xdxfgc/chuan-bo-tong-xin/beidou_gps_test/README.md

# 船舶终端（ESP32 + 北斗 + 激光测距 + LoRa 信标接收 + 语音播报）

一块板子做四件事：读北斗定位、读激光测距、用 LoRa 收信标坐标、用语音把落水信标的方向和距离喊出来，
同时把这些数据发布到网页上。

## 一、代码结构

程序按功能拆成模块，每个模块一对 `.h` / `.cpp`，配置集中在 `config.h`。
以后新增硬件，照 `tof.h` / `tof.cpp` 的写法再加一对文件，
然后在主程序 `setup()` 里加一行 `xxxBegin()`、在 `loop()` 里加一行 `xxxUpdate()` 即可。

| 文件 | 作用 |
| --- | --- |
| `beidou_gps_test.ino` | 主程序：初始化各模块并调度 |
| `config.h` | 全部引脚、WiFi、射频、播报节奏等参数 |
| `gb2312_voice.h` | SYN6288 播报用的 GB2312 词表 |
| `gnss.h` / `gnss.cpp` | 北斗定位：NMEA 解析、0x01 位姿帧、定位失锁告警 |
| `tof.h` / `tof.cpp` | 激光测距 VL53L1X ×2：船头（前方距离）+ 右舷（侧靠距离） |
| `oled.h` / `oled.cpp` | OLED 显示（SSD1306 128x64，与激光共用 I2C） |
| `imu.h` / `imu.cpp` | MPU6050 六轴姿态（同样挂在 I2C 总线上） |
| `mag.h` / `mag.cpp` | 磁力计 GY-282（HMC5983）：航向、标定、I2C 自恢复，走**独立的 Wire1** |
| `berth.h` / `berth.cpp` | 靠泊辅助：距离滤波、接近速度拟合、分级告警、靠妥判定 |
| `buzzer.h` / `buzzer.cpp` | 蜂鸣器：汇总各级告警，用不同节奏响铃，支持网页开关 |
| `anchor.h` / `anchor.cpp` | 走锚监测：基准位置、位移平滑、漂移趋势、0x21/0x22 告警 |
| `logbook.h` / `logbook.cpp` | 数据记录与回放：每秒存一帧，可下载 CSV、按时间轴回放 |
| `button.h` / `button.cpp` | 板载 BOOT 键：短按设出发点，长按开始标定 |
| `cmd.h` / `cmd.cpp` | 串口命令：音量、标定、出发点、磁偏角、扫描 |
| `lora_link.h` / `lora_link.cpp` | LoRa 收发与 ACK 应答 |
| `voice.h` / `voice.cpp` | SYN6288 语音播报与在线调音量 |
| `beacon.h` / `beacon.cpp` | 信标接收、方位解算、搜索引导、播报节流 |
| `net.h` / `net.cpp` | WiFi 与网页服务（页面 + JSON 接口） |

依赖方向是单向的：`config` 在最底层；`beacon` 用到 `gnss`/`lora`/`voice`；
`net` 用到 `gnss`/`tof`/`beacon`；主程序把它们串起来。

注意：LoRa 模块的文件名是 `lora_link.*`，不能叫 `lora.*`。Windows 不区分文件名大小写，
如果叫 `lora.h`，`#include <LoRa.h>`（库头文件）会优先匹配到同目录的这个文件，
导致库加载失败、编译时报 `'LoRa' was not declared`。

## 二、接线

北斗定位模块 ATGM336H-5N：

| 模块引脚 | ESP32 | 说明 |
| --- | --- | --- |
| 5V | 5V | 供电 |
| GND | GND | 必须共地 |
| TX | GPIO17 | 模块发数据，接 ESP32 接收脚 |
| RX | GPIO18 | ESP32 发数据，接模块接收脚 |

激光测距模块 VL53L1X ×2（I2C，船头一只 + 右舷一只）：

| 模块引脚 | ESP32 | 说明 |
| --- | --- | --- |
| VIN | 3.3V | 只能接 3.3V，接 5V 会烧坏 |
| GND | GND | 必须共地 |
| SCL | GPIO22 | I2C 时钟 |
| SDA | GPIO21 | I2C 数据 |
| GPIO1 | 空着 | 可以不接 |

两只都是 I2C，**SDA/SCL 并联到同一对 GPIO21/22**（I2C 是总线，靠地址区分设备，
不是一根线只能挂一个模块）。但两只 VL53L1X 出厂地址**都是 0x29**，直接并上去会
互相打架，所以右舷那只要多接一根 XSHUT：

| 第 2 只（右舷）引脚 | ESP32 | 说明 |
| --- | --- | --- |
| VIN / GND | 3.3V / GND | 和船头那只共用 |
| SDA / SCL | GPIO21 / GPIO22 | 和船头那只并联 |
| **XSHUT** | **GPIO32** | 上电时序用，**必须接**；船头那只的 XSHUT 保持空着 |

上电顺序写死在 `tofBegin()` 里：按住右舷那只 → 船头那只拿到 0x29 →
把它改到 0x2A → 放开右舷那只（它回到 0x29）。这样两只地址就分开了。
串口会打印两只各自的地址，看到两个不同的地址才算成功。

OLED 显示屏 SSD1306（I2C，和激光共用同一条总线）：

| 模块引脚 | ESP32 | 说明 |
| --- | --- | --- |
| VCC | 3.3V | 供电 |
| GND | GND | 共地 |
| SDA | GPIO21 | 和激光共用 |
| SCL | GPIO22 | 和激光共用 |
| 地址 | 0x3C | 少数模块是 0x3D，读不出就改 config.h |

MPU6050 六轴姿态（I2C，同样挂在这条总线上）：

| 模块引脚 | ESP32 | 说明 |
| --- | --- | --- |
| VCC | 3.3V | 供电 |
| GND | GND | 共地 |
| SDA | GPIO21 | 和激光、OLED 共用 |
| SCL | GPIO22 | 和激光、OLED 共用 |
| AD0 / ADO | GND 或不接 | 地址 0x68；接高电平变 0x69 |
| INT / XDA / XCL | 不接 | 暂时用不上 |

磁力计 GY-282 / HMC5983（**单独一路 I2C，不和其他模块共用**）：

| 模块引脚 | ESP32 | 说明 |
| --- | --- | --- |
| VCC | **3.3V** | 不能接 5V：上拉电阻会跟着抬到 5V，超出 ESP32 的 IO 耐压 |
| GND | GND | 共地 |
| SDA | **GPIO25** | 走 Wire1 |
| SCL | **GPIO26** | 走 Wire1 |

两条 I2C 总线是分开的：**Wire**（GPIO21/22）挂激光 0x29、OLED 0x3C、MPU6050 0x68；
**Wire1**（GPIO25/26）只挂磁力计 0x1E。分开的原因是磁力计代码里带自动降速和总线复位，
和激光共用一条线时，它一折腾会连带影响每 50 毫秒就要读一次的激光测距。
想省一对脚的话，把 `config.h` 里的 `I2C_BUS_INDEX` 改成 0、`I2C_SDA`/`I2C_SCL` 改成 21/22 即可。

I2C 是总线，多个器件共用同样两根线靠地址区分：**激光 0x29、OLED 0x3C、MPU6050 0x68**，
三个地址互不冲突，挂在一起没问题。

⚠ MPU6050 里没有磁力计：俯仰角和横滚角很准，但偏航角（船头朝向）会随时间漂移。
要做到"信标在左前方"这种相对船头的播报，还需要再加一片三轴磁力计（文档里配的是 QMC5883L，
地址 0x0D，同样可以挂在这条总线上）。

LoRa 模块 SX1278（Ra-01 / Ra-02，433MHz，SPI）：

| 模块引脚 | ESP32 | 说明 |
| --- | --- | --- |
| VCC | 3.3V | 只能 3.3V |
| GND | GND | 共地 |
| SCK | GPIO14 | SPI 时钟 |
| MISO | GPIO19 | SPI 数据入 |
| MOSI | GPIO23 | SPI 数据出 |
| NSS | GPIO13 | 片选 |
| RST | GPIO27 | 复位 |
| DIO0 | 不接 | 程序用轮询，不需要中断脚 |

SYN6288 语音模块：

| 模块引脚 | ESP32 | 说明 |
| --- | --- | --- |
| RXD | GPIO16 | 必接，ESP32 发、模块收 |
| TXD | GPIO4 | 可选，接上能看到模块应答 0x41 |
| VCC | 5V | 功放吃电流，5V 声音才够大 |
| GND | GND | 共地 |
| SPK+ / SPK- | 喇叭 | 接小喇叭 |

接 ESP32 时，北斗模块上的 USB 口不要同时插到电脑，两者是同一路串口，会冲突。
北斗天线要拧到 SMA 口上，放在露天、平面朝天，远离金属。

## 三、WiFi 配置

相关设置都在 `config.h` 里。当前用固定 IP，网页地址固定为 **http://192.168.31.200**。

| 项目 | 值 |
| --- | --- |
| SSID | Xiaomi_AE4D |
| 密码 | 123456780 |
| 网段 | 192.168.31.x |

小米路由器有两个 WiFi 名字：**不带 `_5G` 的是 2.4GHz，带 `_5G` 的是 5GHz**。
ESP32 只支持 2.4GHz，必须用 `Xiaomi_AE4D`。

固定 IP 连不上会自动回退成路由器自动分配；再连不上就开热点兜底：
热点名 `Beidou-GPS`、密码 `12345678`、网页地址 http://192.168.4.1。

## 四、LoRa 通信协议

和信标端（ESP32-C3）约定好的文本协议，两边必须一致：

```
信标 → 广播：  M,<信标ID>,<序号>,P,<定位有效 0/1>,<纬度>,<经度>
本板 → 广播：  S,<船ID>,<序号>,P,<定位有效 0/1>,<纬度>,<经度>,<对地速度节>,<航向度>,<卫星数>
本板 → 信标：  A,<船ID>,<序号>,C,<本方定位有效 0/1>,<纬度>,<经度>
```

**第二位是发送者标识**：船端用 `DEV_ID = 1`，信标用 11 / 12 / 13（在各自的 `config.h` 里设）。
岸基节点靠它区分"这一帧是谁发的"，才能同时管理多个目标。
收到带编号的帧时，串口、OLED 和网页上都会显示是哪个信标。

**前缀区分角色**：`M` 是信标、`S` 是本船广播、`A` 是应答。

信标每 2 秒发一次，本板收到立刻回 ACK，信标靠它判断这一轮成功。
本板自己也广播一帧自己的状态（`BROADCAST_MS`），这样岸基节点才有东西可收。
**但广播要让信标的路**：本机一发射就听不见东西（半双工），原来固定每 2 秒发一帧，
刚好和信标 2 秒一次的上报同拍，会把 SOS 包顶掉、逼信标重传。现在的规则是——

- 信标不在线（超过 `BROADCAST_QUIET_MS` 没收到包）：每 `BROADCAST_MS`（5 秒）发一帧
- 信标在线：只在**刚给信标回完 ACK、信标正处在自己那 2 秒静默期**的空档里发
  （收到包后 `BROADCAST_SLOT_MIN_MS` ~ `BROADCAST_SLOT_MAX_MS` 这段窗口），
  所以实际间隔约 5~8 秒，永远不会压住 SOS

判断用的是 `beaconLastPacketAgeMs()`：距上次收到信标包过了多久。收包时刻本身就是
最好的相位基准，不用两端对表。
重传识别是**按发送者分开记**的：同一只发送者、同一序号重复到达只回 ACK，
不重复播报；多只信标同时工作时不会互相误判成重传。

解析器**两种格式都认**：如果第二个字段是数字就是新格式（带 ID），第三个字段是 `P` 就是老格式（没有 ID，当作 srcId = 0）。这样以后碰到别的项目里现成的发送端，不改它也能收。

射频参数两端必须完全相同：`433MHz / SF10 / BW125kHz / 同步字 0x12 / 开启 CRC`。

## 五、语音播报

SYN6288 只认 GB2312，不能直接发 UTF-8 中文，所以 `gb2312_voice.h` 里把要用到的词
预先算成字节，数字和 `[v16]` 音量标记在运行时拼上去。

播报内容形如："人员落水，信标在东北方向，距离约 123 米，坐标北纬 26.2091 度，东经 111.5989 度。"

为避免语音排队，做了节流：两次播报最短间隔 8 秒；目标移动超过 3 米、方位变化、
或超过 20 秒，才重新播报。链路中断超过 15 秒播报"与信标失去联系"，恢复时播报"通信已恢复"。

方位播报会优先使用**相对船头**的八个方位（正前方、右前方……左前方），前提是磁力计在位**并且已经标定**；
没标定或者磁力计掉线时，自动退回"信标在东北方向"这样的绝对方位，避免给出错误指引。

## 六、串口命令

串口监视器波特率 **115200**，行尾选「换行」或「NL & CR」。输入 `help` 可以看全部命令：

| 命令 | 作用 |
| --- | --- |
| `v0` ~ `v16` | 语音音量（会播一句"你好"试听） |
| `cal [秒]` | 开始磁力计标定，默认 15 秒（拿起来绕「8」字慢慢转） |
| `cal stop` | 提前结束标定 |
| `cal reset` | 清除已保存的标定 |
| `zero` | 把当前船头朝向设为出发点（0°） |
| `decl -5.2` | 设置磁偏角（真北修正），长沙一带约 -5 |
| `mag` | 立刻打印一行磁力计数据 |
| `dock` | 打印靠泊状态（距离、接近速度、告警） |
| `scan` | 扫描磁力计所在的 I2C 总线，正常应看到 0x1E |
| `ack` | 确认落水告警（停止蜂鸣器） |
| `buzz on` / `buzz off` | 打开或关闭蜂鸣器（网页上也有按钮） |
| `moor set` | 把当前位置设为锚泊基准，开始走锚监测 |
| `moor clear` | 清除锚泊基准，停止监测 |
| `moor` | 打印锚泊状态（位移、漂移方向与速率） |
| `log on` / `log off` | 开始或暂停数据记录 |
| `log dump` | 把已记录的数据以 CSV 打印到串口（可直接存成文件） |
| `log clear` | 清空记录 |

## 七、板载按键

ESP32 开发板上的 **BOOT 键**（GPIO0）可以直接操作，不用开电脑：

| 动作 | 效果 |
| --- | --- |
| 短按 | 把当前船头朝向设为出发点（0°） |
| 长按 3 秒 | 开始磁力计标定 |
| 标定中短按 | 提前结束标定，用已转到数据算结果 |

不想用就把 `config.h` 里的 `BTN_ENABLE` 改成 0。

## 八、靠泊辅助

只用激光测距，不需要额外硬件。**靠近到 3.5 米自动开始监测**，离开到 3.8 米（滞回 0.3 米）
并持续 3 秒后自动结束。

### 用哪一路激光：右舷优先，看不到岸就退回船头

船上装了两只激光：

- **船头那只**测正前方到岸/障碍的距离 —— 顶着靠、前方防撞
- **右舷那只**测船侧到码头的横向距离 —— **侧靠**，也就是真实船舶靠泊的方式

两只都有效时怎么选，`config.h` 里的 `BERTH_SRC_MODE` 决定：

| 值 | 含义 |
| --- | --- |
| `BERTH_SRC_AUTO`（默认 `0`） | 右舷那只有效、且距离进了靠泊区 → 用右舷；否则自动退回船头 |
| `BERTH_SRC_BOW`（`1`） | 固定用船头（顶着靠） |
| `BERTH_SRC_SIDE`（`2`） | 固定用右舷（侧靠） |

**为什么要"自动"**：这样你两种演示都不用改代码、也不用重新烧录——船头对着岸开过去时，
右舷那只照到的是一片水面、读数是无效的，逻辑自动用船头；船横过来贴近码头时，
右舷那只一进到 3.5 米就被选中。判定动画和告警规则**完全一样**，只是数据来源换了。

退回船头的时候用**退出阈值 3.8 米**做滞回，免得两个距离在 3.5 米附近来回跳——
每跳一次都会重开一次监测，那样永远判不出靠妥。

中途换源（比如从顶着靠改成侧靠）时会**主动结束本次监测、当新事件重新进入**。
因为两路距离的基准不一样，硬接着算会在速度拟合窗里顶出一个假尖峰，直接变成误告警。

网页「④ 靠泊」里有一栏"**数据来源**"，直接告诉你当前用的是船头还是右舷；
OLED 靠泊画面的标题也会变成"靠泊·右舷"或"靠泊·船头"。

处理链是：原始距离先做 3 点中值去野值，再做 8 点滑动平均；然后用 0.4 秒窗口做最小二乘拟合
求接近速度。这两步是必须的——激光噪声约 ±5 毫米，直接拿相邻两帧求差算速度，误差有 0.1 m/s，
而提醒阈值才 0.15 m/s，噪声就能把告警刷满。

判断规则按文档附录 B：

| 告警码 | 条件 | 等级 | 播报 |
| --- | --- | --- | --- |
| 0x01 | 接近速度 > 0.15 m/s | 提醒级 | 靠泊速度偏大，请减速 |
| 0x02 | 接近速度 > 0.30 m/s | 严重级 | 靠泊速度过大，立即停船 |
| 0x03 | 距岸 < 0.5 米且速度 > 0.10 m/s | 严重级 | 距岸过近，请停船 |

告警带 3 帧去抖，并且**解除阈值比触发阈值松约 10%**：

| 告警码 | 触发 | 解除 |
| --- | --- | --- |
| 0x01 接近速度偏大 | 速度 > 0.15 | 速度 < 0.13 |
| 0x02 接近速度过大 | 速度 > 0.30 | 速度 < 0.27 |
| 0x03 距岸过近 | 距离 < 0.5 且速度 > 0.10 | 距离 > 0.55 或速度 < 0.09 |

光有去抖不够——速度正好在阈值上下浮动时，蜂鸣器会一秒响一次停一次地“哒哒”跳。
留出滞回差值之后就不会了。当前生效的那一级用解除阈值判断，其它级用触发阈值，
所以不会耽误升级（比如提醒级时速度冲到 0.31，立刻升到严重级）。

**距离播报**按档位给，越近播得越勤：

| 距离 | 播报 | 间隔 |
| --- | --- | --- |
| 3.5 ~ 2.0 米 | 距离三米二 | 2.5 秒 |
| 2.0 ~ 1.0 米 | 距离一米八 | 2.0 秒 |
| 1.0 ~ 0.5 米 | 距离八十厘米 | 2.0 秒 |
| 0.5 米以内 | 距离三十厘米，即将靠妥 | 2.0 秒 |

告警优先级高于距离播报，触发时先念告警。**拟合速度小于 0.02 m/s 时自动静默**，不会反复念
同一个数字。这里用速度而不是距离变化量来判断——船靠在码头边随浪起伏时距离一直在变，
用极差永远判不出"停稳"，而浪造成的往复平均速度接近零，用速度就能安静下来。

**靠妥判定**看的是"停下来"而不是"有多近"：速度小于 0.03 m/s（主判据）、观察窗内极差小于
8 厘米（辅助，用来挡住一个大浪把船推一截）、且距离小于 1 米，三条同时满足就播报"靠泊完成"。
这样护舷厚薄都不影响判定。另外，激光量程下限是 4 厘米，如果刚才还贴着、读数突然失效，
也判为已接触。

极差容差取 8 厘米而不是更小，是因为水面上的船一直在晃：3.2 秒内变化 3 厘米相当于 0.01 m/s，
比速度阈值还严三倍，正常靠泊永远达不到。

判定外面还套了四道防护，防止"一开机就对着近处目标"被误判成刚刚靠好：

- **窗口必须攒够样本**：拟合窗要填满（8 个点）、观察窗至少攒到一半（约 1.6 秒）。
  样本不足时不允许下结论——早期版本这里返回 0，被当成"速度为零、距离没变"，只要距离小于 1 米
  就会立刻误判靠妥。
- **进入监测后至少观察 2 秒**，刚进来什么都没看清不能判。
- **必须实际接近过 30 厘米以上**：记录进入监测后见过的最大距离，要求它和当前距离的差达标。
  这条专门挡住"开机时激光就已经对着 1 米以内目标"的情况。
- **离开岸壁会自动解除**：靠妥后如果距离超过 1.5 米并持续 1 秒，解除"已靠妥"回到监测状态，
  不会卡在靠妥状态出不来。

**屏幕占用**也有条件：只有出现告警、已经靠妥、或者船确实在移动（速度超过 0.01 m/s）时，
屏幕才切到靠泊画面；否则保持显示信标或本船画面，避免长时间停在近处就把别的画面顶掉。

阈值全在 `config.h` 里，实测觉得太敏感或太迟钝直接改。

## 九、蜂鸣器

有源蜂鸣器，接在 **GPIO33**（模块说明书里示例写的 GPIO27 已被 LoRa 的 RST 占用）。

| 模块引脚 | ESP32 |
| --- | --- |
| VCC | 3.3V |
| GND | GND |
| I/O | GPIO33 |

**触发极性**在 `config.h` 里选，两种模块都支持：

```
#define BUZZER_ACTIVE_LOW 0    // 1 = MH-FMD（低电平触发）  0 = MH-FMG（高电平触发）
```

接反了的表现正好相反：该响的时候不响、不该响的时候一直响。**上电时如果听到"滴"一声，多半就是极性设反了**——代码里已经把输出电平设在切换成输出之前，正常情况下上电不会响。

蜂鸣器把三个模块的告警汇总成一个等级，用不同节奏区分：

| 等级 | 触发条件 | 响法 |
| --- | --- | --- |
| 3 | 人员落水（收到信标有效坐标） | 三短声急促循环 |
| 2 | 靠泊速度过大 0x02、距岸过近 0x03、走锚 0x22、信标失联 | 两短声循环 |
| 1 | 靠泊速度偏大 0x01、疑似走锚 0x21、定位失锁 0x06 | 单短声，每 2 秒 |

多个告警同时出现时取最高等级。落水告警要人工确认（串口敲 `ack`）才解除；同一事件确认后不再重复报警，等失联再恢复才算新事件。

**网页上有开关**——页面顶部的"蜂鸣器"按钮，可以随时关掉。关掉之后如果告警全部解除、或者出现比关掉时更高等级的告警，它会自动恢复，不用手动打开。按钮上会显示当前状态：待机 / 提醒级告警 / 严重告警 / 人员落水 / 已关闭。

串口命令：`ack` 确认落水告警，`buzz on` / `buzz off` 开关蜂鸣器。

节奏参数在 `buzzer.cpp` 顶部那三张 `PAT` 表里，觉得太吵或者不够醒目直接改数字。

## 十、走锚监测

船靠好或抛锚稳定后，用**网页上的"设锚泊基准"按钮**（或串口 `moor set`）把当前位置记为原点，
之后持续监测位移。判定按文档附录 B：

| 告警码 | 条件 | 等级 | 播报 |
| --- | --- | --- | --- |
| 0x21 | 位移超限（默认 2 米）并持续 60 秒 | 提醒级 | 疑似走锚，位移 2.4 米，漂移方向东南 |
| 0x22 | 位移持续增大且速率没有放缓 | 严重级 | 船正在走锚，请立即处理 |

位移回到 1.8 米以内（滞回）就解除，并播报"位移已回到正常范围"。

**为什么必须对"位置"做平滑，而不是对"位移"平滑**：位移恒为非负，船在基准附近来回摆动时，
位移的平均值会明显大于零（正偏置），越平均越像"漂走了"。所以代码里是把最近 30 秒的**经纬度**
取平均，再用这个平均位置算到基准的距离。

**趋势判断**用两段最小二乘：最近 30 秒的位移增长率（当前速率）和再往前 30 秒的增长率。
0x22 的条件是"位移超限 + 当前速率超过 0.02 m/s + 速率没有放缓"，这样能区分
"船在原地来回摆"（平均速率接近零）和"真的在单向漂走"。

**激光辅助**：停靠在码头时，代码还会盯住与岸壁的距离变化——激光是毫米级，比 GNSS 灵敏得多。
如果距离变化超过 0.5 米并持续 10 秒，也判疑似走锚。注意激光只能测**横向**位移；
沿码头前后方向的漂移它测不到，那还得靠 GNSS。

网页上有一条**位移趋势曲线**，蓝色是实测位移、红色虚线是 2 米阈值，能一眼看出是
"来回摆动"还是"持续漂移"。

## 十一、数据记录与回放

每秒把一帧系统状态压进 RAM 环形缓冲，容量 900 条（约 15 分钟）。

**只占内存、不写 flash**。原因是 flash 每秒写一次会磨损（寿命约 10 万次擦写），
而且本项目不需要长期脱机记录；真要长期记录，应该由上位机负责。

**记录内容**按文档"数据记录规范"的要求挑：时间戳、经纬度、卫星数、HDOP、定位状态、
激光距离、俯仰、横滚、航向、锚泊位移、靠泊告警码、锚泊告警码、链路状态、信标距离。

**三个出口**：
- **串口**：敲 `log dump` 把全部数据以 CSV 打印出来，电脑上直接存文件
- **网页下载**：数据记录标签页里点"下载 CSV"，文件带表头，Excel 直接能开
- **网页回放**：点"加载回放数据"，然后拖滑块或用"播放 / 暂停"逐条浏览，能看到每一刻的位置、距离、姿态和告警

CSV 的表头是：

```
t_ms,time,lat,lon,sats,hdop,fix,tof_mm,pitch,roll,heading,drift_m,berth,anchor,link,beacon_m,tof2_mm
```

其中 `tof_mm`（船头）、`tof2_mm`（右舷）和 `heading` 在对应模块不可用时留空
（不是 0，"没有数据"和"数值是 0"要分清楚）。新加的 `tof2_mm` 放在最后一列，
是为了不打乱前面各列的顺序——网页回放和已有的 CSV 都不用改。

## 十二、信标—本船相对态势图

打开网页的 **⑥ 信标** 标签页，下面是一张**俯视态势图**（浏览器用 canvas 画的，不是视频、
也不是真实地图，所以不需要联网、不占流量）：

- 圆心永远是**本船**：蓝色三角，尖头指船首方向
- 信标是**红点**，外面一圈呼吸圈，旁边写"信标 11"
- 两点之间是虚线，中间标注**距离和方位**，例如 `123 m · 东北`
- 一圈圈同心圆是**距离圈**，量程自动跟着信标距离走（10 m ~ 10 km 分档），图下方写着当前量程
- 橙色细线是**本船航迹**，能看出船是从哪个方向开过来的

两个按钮：

- **视图：船头朝上 / 正北朝上**。船头朝上时画面正上方就是船首方向，操船时直观；
  正北朝上时和纸质海图一致，报方位、做记录时直观。
- **清除航迹**：把橙色航迹清掉重新记。

**"船头朝上"必须有航向**，取值顺序是：磁力计已标定 → 用磁力计航向（图上会注明"用磁力计航向"）；
否则退回 GPS 航迹向（只有速度大于 0.5 km/h 才有意义）；两者都没有就自动切回正北朝上，
宁可切换视图，也不画一个错的方向。

图下方的灰字会直接说清当前状态，例如：

```
本船相对信标：123 m，方位 相对船头 左前方　视图：船头朝上（用磁力计航向）
还没收到信标坐标，正在等待信标回传。
信标链路已离线，图上显示的是最后一次收到的位置。
```

链路离线时红点会变灰、停止呼吸，提示"这是旧位置"，不会被误当成实时目标。

为什么要画它：**语音只说得出一句"左前方 123 米"，人要自己在脑子里把这句话转成水面上的位置**。
有了态势图，本船、信标、距离圈、航迹、船头方向全在同一张图上，可以边操船边看信标是在
左前方还是右后方、距离是在拉大还是在缩小 —— 这正是回旋搜索时最需要的判断。

图上所有位置都是浏览器用两点的经纬度**现算**的（本地平面近似，几百米量级误差远小于 1 米），
ESP32 只负责把两个坐标发过来，不占额外资源。

## 十三、在 Arduino IDE 中烧录

1. 安装 ESP32 支持包：开发板管理器搜索 `esp32`，装 Espressif Systems 的包。
2. 用 Arduino IDE 打开 `beidou_gps_test.ino`（其余文件会在同一窗口里一并打开）。
3. 开发板按实际硬件选 **ESP32 Dev Module** 或 **ESP32S3 Dev Module**（两种都已验证能编译）。
4. 端口选 ESP32 对应的串口，点上传。失败时按住板上 BOOT 键再上传。

用到的库都已装在这台电脑的 Arduino 库里：`VL53L1X` 1.3.1（Pololu）、`LoRa` 0.8.0（sandeepmistry）。
换电脑时在库管理器里各搜一个装上即可。

## 十四、查看结果

串口监视器波特率 **115200**。每秒打印五块内容：北斗定位、激光距离、姿态（俯仰/横滚/温度）、
磁力计（航向/相对出发点/磁场强度/是否已标定）、信标链路状态（在线与否、RSSI、信标坐标、搜索引导）。

OLED 屏幕有四种画面，按优先级自动切换：**落水告警** → **靠泊**（有告警、已靠妥或正在移动）→
**锚泊**（设了基准）→ **信标**（收到坐标）→ **本船状态**。
靠泊和锚泊优先是因为那是人在主动操作或值守、需要盯着屏幕看。

下面两种是信标画面和本船状态画面（磁力计已标定，方向按相对船头显示）：

```
信标坐标              -95dBm       本船状态          13星 3D
N26.209136                         N26.209136
E111.598909                        E111.598909
左前方 123米           ↗            激光 1234mm  航向201
本船 26.2091 111.5989              俯仰 3.2  横滚 1.8
```

收到过信标坐标时显示左边那一屏，还没收到时显示右边的本船状态。
左边那屏箭头上方的小尖表示"屏幕上方就是船头"；磁力计没标定时箭头会退回指北，文字也变成"东北"这样的绝对方位。

靠泊画面的布局是：第一行"靠泊监测"加右侧的等级（正常/提醒/严重/已靠妥），中间一行大号距离数字
带单位，下面一行接近速度，最后一行是状态或告警文字。

网页地址 **http://192.168.31.200**，页面按功能分成**八个标签页**：
① 定位 ② 测距 ③ 姿态 ④ 靠泊 ⑤ 锚泊 ⑥ 信标 ⑦ 原始数据 ⑧ 数据记录。
② 里同时显示**前方距离（船头）**和**右舷距离（到码头）**两路；
④ 里多一栏**数据来源**，告诉你当前靠泊判断用的是哪一路激光。
⑤ 里有一条**锚泊位移趋势曲线**（红线是 2 米阈值），⑧ 里可以下载 CSV、按时间轴回放。
⑥ 里有一张**信标—本船相对态势图**（本船在圆心、信标为红点、带距离圈和航迹，可切船头朝上 / 正北朝上）。
顶部的状态横幅和三个按钮常驻，不随标签切换：

- **蜂鸣器**开关：关掉只是在闭嘴，**告警本身还在**——等级再升一档它会自己恢复
- **确认落水告警**：落到水里发出的告警必须人工确认才解除（三短声会一直响）。
  信标在报落水时这个按钮变红、写着"确认落水告警"，点一下就解除，
  和串口敲 `ack` 完全等效。没告警时它是灰的"无落水告警"，点了不做事。
- **设锚泊基准 / 清除锚泊基准**

收到有效信标坐标时，顶部横幅变成红色落水提示，显示方向和距离。

## 十五、程序空间提醒

现在整个程序大约 **1.31MB**，而默认分区的「Default 4MB with spiffs」只给程序留
**1.3MB（1,310,720 字节）**——已经贴着天花板了，实测只剩不到 1KB 余量。

**所以编译前必须在 Arduino IDE 里把「工具 → Partition Scheme」改成
Huge APP (3MB No OTA/1MB SPIFFS)**，程序可用空间从 1.3MB 变成 3MB，不用改任何代码。
不改的话，稍微再加点东西就会报 `Sketch too big`。

为什么这么大：整张网页（HTML+JS）是跟着程序一起烧进 flash 的，现在约 24KB；
OLED 的中文字库还要 200KB 左右。**网页是省 flash 时最该盯的地方**——
所以 `net.cpp` 里那个 HTML 字符串故意不缩进、不写注释，改页面时请保持紧凑写法。

## 十六、常见问题

- LoRa 初始化失败：检查 3.3V 供电和 SPI 五根线，确认模块是 Ra-01/Ra-02 的 433MHz 版本。
- 收不到信标：确认信标端的频率/SF/带宽/同步字和本板完全一致，天线接好。
- 语音不响：确认模块供电 5V、喇叭接在 SPK+/SPK-、GPIO16 接模块 RXD。
- 网页打不开：确认手机或电脑和 ESP32 在同一网络，地址用 `http://` 开头。
- 串口没有定位输出：检查 TX/RX 是否接反、天线是否接好、波特率是否为 9600。
