xdxfgc/chuan-bo-tong-xin/C3_Coord_Sender/config.h

/* =====================================================================
   config.h   信标（坐标发送端）的全部可调参数
   ---------------------------------------------------------------------
   换接线、改参数只动这一个文件。
   ===================================================================== */

#ifndef CB_CONFIG_H
#define CB_CONFIG_H

#include <Arduino.h>
#include <SPI.h>
#include <LoRa.h>      // 库集中在这里包含：Arduino 的库发现机制有时扫不到
                       // 只被额外 .cpp 包含的库，写在 config.h 里最稳

/* ---------------- 本机标识 ----------------
   每只信标一个不同的编号，船端和岸基靠它区分“这一帧是谁发的”。
   第一只用 11，第二只 12，第三只 13……（船端是 1）。
   三只信标烧同一个程序时，改这一行后再烧下一只。                       */
/* 这里用 #ifndef 包一层：既能在本文件里改，也能在编译时用
   -DDEV_ID=12 覆盖（一次编译出多只信标时方便）。                */
#ifndef DEV_ID
#define DEV_ID    11
#endif

/* ---------------- 引脚（ESP32-C3 SuperMini + SX1278） ----------------
   SCK -> GPIO6     MISO -> GPIO2     MOSI -> GPIO7
   NSS -> GPIO10    RST  -> GPIO8     DIO0 -> 不要接！
   3V3 -> 3V3       GND  -> GND

   ⚠ DIO0 千万不能接：那个位置是 GPIO9，是启动模式脚，
     接上之后芯片复位就进下载模式，程序根本不跑。
     本程序用轮询读中断标志，不需要 DIO0。                            */
#define SCK_PIN   6
#define MISO_PIN  2
#define MOSI_PIN  7
#define NSS_PIN   10
#define RST_PIN   8
#define DIO0_PIN  -1

/* ---------------- 射频参数（必须与船端完全一致） ---------------- */
#define RF_FREQ   433E6
#define RF_SF     10
#define RF_BW     125E3
#define SYNC_WORD 0x12

/* ---------------- 通信节奏 ---------------- */
/* 上报节奏分两档：
     正常值守（没入水）—— 慢发，只为了让各方知道"我在线"
     已入水          —— 快发，落水搜救要的是及时
   三端同时工作时信道很挤，平时放慢能把空口时间让出来。              */
#define ROUND_PERIOD_MS   2000    // 入水后的每轮间隔
#define IDLE_HEARTBEAT_MS 8000    // 平时的心跳间隔（比船端的 15 秒链路超时留足余量）

#define ACK_TIMEOUT_MS  1200      // 等应答最长时间
#define MAX_RETRY       3         // 等不到应答最多重发几次
#define TX_TIMEOUT_MS   800       // 单次发送等 TxDone 的上限

/* ---------------- 水感检测（落水触发） ----------------
   硬件：两片不锈钢电极，间距 3~5 毫米，分别接下面两个脚。
         自制电路，不需要任何电阻电容。平时两个脚是高阻，零功耗。

   临时测试不用做电极：两根杜邦线插这两个脚，线头碰一起就是"入水"。
   以后换上真电极，代码一行都不用改。

   脚位只能从空闲脚里挑：GPIO0 / 1 / 3 / 4 / 5
   （2、6、7、8、10 被 LoRa 占了，9 是启动脚，20/21 是北斗）        */
/* 下面几个也包了 #ifndef：既能在本文件里改，也能编译时用 -D 覆盖
   （一次编译出两种版本时方便）。                                   */
#ifndef WATER_PIN_A
#define WATER_PIN_A      3
#endif
#ifndef WATER_PIN_B
#define WATER_PIN_B      4
#endif
#define WATER_SAMPLE_MS  500      // 采样间隔（越小越灵敏，越大越省电）
#define WATER_CONFIRM_MS 2000     // 连续湿多久才算真落水（三重确认的"持续时间"）

/* 定期状态行：每 WATER_STATUS_MS 毫秒打一行，不管有没有水都打。
   串口监视器上一直能看到水感的当前状态，不用碰线头、不用敲命令。
   不想看就设成 0（只在状态变化时打印）。                             */
#ifndef WATER_STATUS_MS
#define WATER_STATUS_MS  5000
#endif

/* 串口模拟命令：1 = 开放 wet on / wet off / wet（演示用，不用碰硬件）
   注意：SRC_MODE = 3 也要读串口，两个不能同时开。                    */
#ifndef WATER_SIM_CMD
#define WATER_SIM_CMD    1
#endif

/* 上报方式：
     1 = 平时静默，水感触发后才上报（省电、省信道，但船端平时显示"离线"）
     0 = **一直上报**（现在这个）。链路随时看得到在线，方便联调和演示；
         船端靠帧里的"水感状态"位决定报不报警，不会因为一直发就乱响。

   等真正要按文档做"平时休眠、入水才醒"的时候，再改回 1。            */
#ifndef SEND_ONLY_WET
#define SEND_ONLY_WET    0
#endif

/* ---------------- 姿态传感器 MPU6050（I2C） ----------------
   接线（野火 MPU6050 模块）：
     3V3 -> 3V3（⚠ 只能 3.3V，接 5V 直接烧）
     GND -> GND
     SDA -> GPIO0
     SCL -> GPIO1
     A0  -> GND（地址固定 0x68）    INT -> 不接

   为什么是 GPIO0/1：其它脚都有主了——
     LoRa 用 2/6/7/8/10，水感用 3/4，北斗用 20/21，9 是启动脚。
     GPIO22 在 ESP32-C3 上根本不存在，别照抄普通 ESP32 的接法。

   三重确认里它管"姿态判定"：分辨"在船上被雨淋/上浪"和"真的漂在水里"。
   注意：下面那几个阈值是经验值，必须用实测数据标定过再用（见 README）。      */
#ifndef POSTURE_SDA_PIN
#define POSTURE_SDA_PIN   0
#endif
#ifndef POSTURE_SCL_PIN
#define POSTURE_SCL_PIN   1
#endif
#define POSTURE_ADDR      0x68     // A0 接 GND 就是 0x68；悬空则是 0x69
#define POSTURE_READ_MS   20       // 读取间隔（20ms = 50Hz，对应文档采集频率）
#define POSTURE_PRINT_MS  1000     // 标定用的数据行打印间隔

/* 判据①：入水冲击的波形特征 —— 先失重（合加速度掉下去），
   紧接着一个冲击尖峰（砸进水里）。被浪打到身上几乎不会出现这个波形。 */
#define POSTURE_FREEFALL_G    0.6f   // 低于这个值算"失重"
#define POSTURE_IMPACT_G      1.8f   // 失重之后又高于这个值算"入水冲击"
#define POSTURE_IMPACT_WIN_MS 800    // 失重后多久内出现冲击，才算同一次落水

/* ---------------- 姿态判定的三条子判据 ----------------
   ⚠⚠ 下面这几个阈值是**推算出来的首版值，没有经过完整实测标定** ⚠⚠

   数据来源：
     · 静止 / 走动 / 抖动  三组是实测的（2026-10-05）
     · 漂浮那一组是用波浪加速度 A·ω² 推算的，没实测
   所以现阶段只保证"能用"，**报告里写"实测标定"之前必须补测漂浮数据**。

   实测依据：
     · 失重门槛 0.6g —— 实测走路最低 0.983g、抖动最低 0.921g，都离得很远，安全
     · 冲击门槛 2.0g —— 实测抖动能冲到 3.69g，所以**单看冲击不行**，
       必须靠"先失重"当前提才能把上浪排除掉
     · 摇摆频率改用频率而不是幅度 —— 实测手持晃动 0.115~0.182g 和走路
       0.059~0.215g 完全重叠，幅度分不开；但走路是 1~2Hz 步态，
       波浪只有 0.1~0.5Hz，频率分得开
   ================================================================ */
#define POSTURE_TILT_MIN_DEG     55.0f   // 判据②：相对基准倾角超过这个算"翻转过"
#define POSTURE_CALM_MAX_G       0.30f   // 判据③：运动（半秒峰峰值）小于这个算"平静"
#define POSTURE_IMPACT_KEEP_MS   30000   // 判据①：冲击事件在这么久内算有效

/* 摇摆频率：**只用来打印展示，不参与激活判定**。
   原因是它需要 8 秒窗口才能算准，而文档要求 3 秒内激活，两者冲突。
   激活判定用"平静度"（判据③）就够 —— 实测抖动时运动 1.3~4.2g，
   而落水后应该很小，差两个数量级。
   频率本身对报告有用（能佐证"确实是波浪的节奏"），所以还是算出来打印。 */
#define POSTURE_SWAY_WIN_MS      8000    // 频率统计窗口长度（8 秒）

/* 姿态判定是否接进报警判断。
   0 = **不参与**（现在这个）。水感导通就报警，姿态只采集、只打印。
       ——"失重→冲击"这个波形只有真掉进水里才有，手上怎么模拟都不像，
         留着它反而会让信标永远触发不了。
   1 = 接入：水感 + 姿态三条都满足才报警（实测标定完阈值再打开）。      */
#ifndef POSTURE_JUDGE
#define POSTURE_JUDGE     1
#endif

/* ---------------- 落水激活状态机 ----------------
   三重确认 = 水感导通 + 姿态符合漂浮 + 持续够久。
   一旦确认激活就**一直保持**，直到人工复位
   （文档 6.3：打捞后擦干，长按复位键五秒退出激活状态）。            */
#define TRIGGER_WAIT_MS   15000    // 水感确认后最多等这么久让姿态条件成立
#define TRIGGER_SIM_ENABLE 1       // 是否开放 sim 命令（演示时强制条件通过）

/* ---------------- 复位按键（板载 BOOT 键） ----------------
   BOOT 键在 GPIO9 上，长按 5 秒退出激活状态，不用额外加硬件。
   ⚠ 上电时别按着它 —— 按住 BOOT 上电，芯片会进下载模式，程序不跑。 */
/* ---------------- 深度休眠与水感唤醒 ----------------
   文档指标：休眠电流 ≤200µA、待机 ≥3 个月、激活后连续工作 ≥12 小时。

   原理：ESP32-C3 深度休眠时 CPU 停、RAM 掉电，只剩 RTC 域在工作，
   电流从 30mA 降到 5µA 左右。C3 没有 RTC IO，但 **GPIO0~5 可以唤醒**，
   水感电极正好在 GPIO3/4。

   睡着时的接法：B 脚被"钉"在低电平（相当于接 GND），A 脚开内部上拉、
   配成"低电平唤醒"。入水 → 水把 A 脚拉低 → 芯片被叫醒。

   ⚠ 唤醒 = 芯片重启，setup() 会从头跑一遍，所有变量清零。

   还有一件必须做的事：**北斗模块平时要断电**，不然它一直吃 30mA，
   待机永远到不了 200µA。断电要在它的 VCC 线上串一个 MOS/三极管，
   控制脚填在 GPS_PWR_PIN。没接开关就先填 -1（功能不受影响，只是省不了电）。 */
#ifndef ENABLE_DEEP_SLEEP
#define ENABLE_DEEP_SLEEP 1        // 1 = 平时深睡、入水才醒；0 = 一直醒着（调试用）
#endif
#define IDLE_TO_SLEEP_MS  30000    // 已激活后，离水超过这么久就回去睡
#define WAKE_LOG_DELAY_MS 300      // 被唤醒时等串口的时间（比冷启动短，抢时间）

/* 给北斗供电的 MOS 控制脚；-1 = 没接开关（北斗常供电，省不了那 30mA） */
#ifndef GPS_PWR_PIN
#define GPS_PWR_PIN       -1
#endif

/* ---------------- 复位按键（板载 BOOT 键） ----------------
   BOOT 键在 GPIO9 上，长按 5 秒退出激活状态，不用额外加硬件。
   ⚠ 上电时别按着它 —— 按住 BOOT 上电，芯片会进下载模式，程序不跑。 */
#ifndef BTN_PIN
#define BTN_PIN           9
#endif
#define BTN_ACTIVE_LOW    1        // 按下时引脚是低电平
#define BTN_RESET_MS      5000     // 长按多久算复位

/* ---------------- 坐标来源（改这里切换） ----------------
   0 = 固定坐标（联调最省事，但发的是假坐标）
   1 = 绕固定点缓慢转圈（演示用，能看方向和距离一直在变）
   2 = 本端接北斗模块，用真实定位
   3 = 串口手动输入目标坐标（不用重烧，串口里敲 “纬度,经度” 回车即可）

   现在用 0：室内联调先用固定坐标，保证每帧坐标都有效，
   这样“通不通”和“定没定位”两件事不会混在一起。

   ⚠ 改成 2 之后，室内基本定不上位（GNSS 要看得到天空）。定不上位时
   信标发的是 P,0,0,0，船端会显示“链路在线”但“信标位置：未定位”，
   也不报警 —— 这不是通信故障，别和“连不上”搞混。
   真要测真实定位，得把天线拿到室外空地上。
   ===================================================================== */
#ifndef SRC_MODE
#define SRC_MODE 0
#endif

/* 模式 0/1 用的基坐标（十进制度，正数 = 北纬 / 东经） */
static const double BASE_LAT = 26.208676;
static const double BASE_LON = 111.599388;

/* 模式 1：以 BASE 为圆心、半径多少米、多久转一圈 */
static const double DRIFT_RADIUS_M = 30.0;
static const double DRIFT_PERIOD_S = 60.0;

/* 模式 2：本端北斗模块接在 C3 的哪两个脚（模块 TX->RX 脚，模块 RX->TX 脚） */
#define GNSS_RX_PIN 20
#define GNSS_TX_PIN 21
#define GNSS_BAUD   9600

#endif
