xdxfgc/chuan-bo-tong-xin/shore_base_node/gb2312_voice.h

/* =====================================================================
   gb2312_voice.h   岸基节点 SYN6288 播报用的 GB2312 字节表
   ---------------------------------------------------------------------
   SYN6288 只吃 GB2312，不能直接发 UTF-8 中文，所以把要用到的词
   全部预先算成字节。数字和 [v16] 这类符号是 ASCII，运行时拼上去即可。
   每个数组末尾都有一个 0x00，长度按「字节数 + 1」算，别改。

   词表和船端（beidou_gps_test/gb2312_voice.h）逐字节一致，
   只保留了岸基节点用得到的那部分。
   ===================================================================== */

#ifndef SB_GB2312_VOICE_H
#define SB_GB2312_VOICE_H

#include <stdint.h>

/* 人员落水， */
static const uint8_t GB_FELL_OVERBOARD[11] = { 0xC8, 0xCB, 0xD4, 0xB1, 0xC2, 0xE4, 0xCB, 0xAE, 0xA3, 0xAC, 0x00 };
/* 信标在 */
static const uint8_t GB_BEACON_AT[7]       = { 0xD0, 0xC5, 0xB1, 0xEA, 0xD4, 0xDA, 0x00 };
/* 方向 */
static const uint8_t GB_DIRECTION[5]       = { 0xB7, 0xBD, 0xCF, 0xF2, 0x00 };
/* ，距离约 */
static const uint8_t GB_DIST_ABOUT[9]      = { 0xA3, 0xAC, 0xBE, 0xE0, 0xC0, 0xEB, 0xD4, 0xBC, 0x00 };
/* 米 */
static const uint8_t GB_METER[3]           = { 0xC3, 0xD7, 0x00 };
/* 公里 */
static const uint8_t GB_KILOMETER[5]       = { 0xB9, 0xAB, 0xC0, 0xEF, 0x00 };
/* ，坐标 */
static const uint8_t GB_COORD[7]           = { 0xA3, 0xAC, 0xD7, 0xF8, 0xB1, 0xEA, 0x00 };
/* 北纬 */
static const uint8_t GB_NORTH[5]           = { 0xB1, 0xB1, 0xCE, 0xB3, 0x00 };
/* 南纬 */
static const uint8_t GB_SOUTH[5]           = { 0xC4, 0xCF, 0xCE, 0xB3, 0x00 };
/* 东经 */
static const uint8_t GB_EAST[5]            = { 0xB6, 0xAB, 0xBE, 0xAD, 0x00 };
/* 西经 */
static const uint8_t GB_WEST[5]            = { 0xCE, 0xF7, 0xBE, 0xAD, 0x00 };
/* 度 */
static const uint8_t GB_DEGREE[3]          = { 0xB6, 0xC8, 0x00 };
/* 收到坐标 */
static const uint8_t GB_RECV_COORD[9]      = { 0xCA, 0xD5, 0xB5, 0xBD, 0xD7, 0xF8, 0xB1, 0xEA, 0x00 };
/* ，本方未定位 */
static const uint8_t GB_SELF_NOPOS[13]     = { 0xA3, 0xAC, 0xB1, 0xBE, 0xB7, 0xBD, 0xCE, 0xB4, 0xB6, 0xA8, 0xCE, 0xBB, 0x00 };
/* 信标未定位，坐标不可用 */
static const uint8_t GB_TARGET_NOPOS[23]   = { 0xD0, 0xC5, 0xB1, 0xEA, 0xCE, 0xB4, 0xB6, 0xA8, 0xCE, 0xBB,
                                               0xA3, 0xAC, 0xD7, 0xF8, 0xB1, 0xEA, 0xB2, 0xBB, 0xBF, 0xC9, 0xD3, 0xC3, 0x00 };
/* 与信标失去联系 */
static const uint8_t GB_LINK_LOST[15]      = { 0xD3, 0xEB, 0xD0, 0xC5, 0xB1, 0xEA, 0xCA, 0xA7, 0xC8, 0xA5, 0xC1, 0xAA, 0xCF, 0xB5, 0x00 };
/* 通信已恢复 */
static const uint8_t GB_LINK_BACK[11]      = { 0xCD, 0xA8, 0xD0, 0xC5, 0xD2, 0xD1, 0xBB, 0xD6, 0xB8, 0xB4, 0x00 };
/* 岸基节点已启动，等待信标 */
static const uint8_t GB_STARTUP[25]        = { 0xB0, 0xB6, 0xBB, 0xF9, 0xBD, 0xDA, 0xB5, 0xE3, 0xD2, 0xD1, 0xC6, 0xF4,
                                               0xB6, 0xAF, 0xA3, 0xAC, 0xB5, 0xC8, 0xB4, 0xFD, 0xD0, 0xC5, 0xB1, 0xEA, 0x00 };
/* 你好 */
static const uint8_t GB_HELLO[5]           = { 0xC4, 0xE3, 0xBA, 0xC3, 0x00 };

/* 8 个绝对方位词：正北 东北 正东 东南 正南 西南 正西 西北
   （下标顺序和 track.cpp 里 geoDirSector() 算出来的扇区一一对应） */
static const uint8_t GB_DIR[8][5] = {
  { 0xD5, 0xFD, 0xB1, 0xB1, 0x00 },   // 正北
  { 0xB6, 0xAB, 0xB1, 0xB1, 0x00 },   // 东北
  { 0xD5, 0xFD, 0xB6, 0xAB, 0x00 },   // 正东
  { 0xB6, 0xAB, 0xC4, 0xCF, 0x00 },   // 东南
  { 0xD5, 0xFD, 0xC4, 0xCF, 0x00 },   // 正南
  { 0xCE, 0xF7, 0xC4, 0xCF, 0x00 },   // 西南
  { 0xD5, 0xFD, 0xCE, 0xF7, 0x00 },   // 正西
  { 0xCE, 0xF7, 0xB1, 0xB1, 0x00 },   // 西北
};

#endif
