xdxfgc/chuan-bo-tong-xin/shore_base_node/net.h

/* =====================================================================
   net.h   岸基节点网络模块
   ---------------------------------------------------------------------
   连接 WiFi（固定 IP 192.168.31.201，失败自动回退；再失败开热点兜底），
   启动网页服务，把本节点定位、信标与船端数据发布到网页和 JSON 接口。
   ===================================================================== */

#ifndef SB_NET_H
#define SB_NET_H

#include "config.h"

void   netBegin();        // 连接 WiFi 并启动网页服务
void   netLoop();         // 周期调用：处理网页请求与掉线重连
bool   netConnected();    // WiFi 是否已连接
String netIP();           // 当前 IP 地址

#endif
