xdxfgc/chuan-bo-tong-xin/shore_base_node/oled.h

/* =====================================================================
   oled.h   岸基节点 OLED 显示屏（SSD1306 128x64，I2C）
   ---------------------------------------------------------------------
   0.96 寸 I2C 版：SDA=GPIO21 / SCL=GPIO22，VCC 接 3.3V。
   和船端接法一致（船端那条总线上还挂着 MPU6050 / VL53L1X，地址不冲突）。
   开机自动扫描 0x3C / 0x3D，扫到哪个用哪个。
   收到信标坐标时显示信标界面，没有时显示岸基节点自身状态。
   ===================================================================== */

#ifndef SB_OLED_H
#define SB_OLED_H

#include "config.h"

void oledBegin();      // 初始化屏幕
void oledUpdate();     // 周期调用：到了刷新间隔就重画一屏

// 屏的诊断状态（给网页用）：初始化了没有、用的是哪几个脚
const char* oledStatusText();

#endif
