xdxfgc/chuan-bo-tong-xin/shore_base_node/tof.h

/* =====================================================================
   tof.h   岸基节点激光测距模块 VL53L1X（I2C）
   ---------------------------------------------------------------------
   和船端同一套写法，去掉靠泊判据相关部分。
   VIN 接 3.3V，SDA=GPIO21 / SCL=GPIO22，与 OLED 共用一条 I2C 总线。
   ===================================================================== */

#ifndef SB_TOF_H
#define SB_TOF_H

#include "config.h"

void     tofBegin();            // 初始化 I2C 与传感器
void     tofUpdate();           // 周期调用：按间隔读取一次距离
void     tofPrintReport();      // 打印一行距离

bool     tofIsReady();          // 模块是否初始化成功
bool     tofIsValid();          // 本次读数是否有效
uint16_t tofDistanceMm();       // 距离（毫米）
String   tofText();             // 供网页显示的文字

#endif
