xdxfgc/chuan-bo-tong-xin/C3_Coord_Sender/cmd.h

/* =====================================================================
   cmd.h   串口命令（全工程唯一读串口的地方）
   ---------------------------------------------------------------------
   为什么要统一：串口只有一个，几个模块各自去读 DBG.available() 会互相
   抢字节。所以命令解析集中在这里，解析完再调对应模块的函数。

   注意：SRC_MODE = 3（串口输入坐标）也要读串口，和这里冲突，
   所以那两个不能同时开 —— 代码里有编译检查挡着。
   ===================================================================== */

#ifndef CB_CMD_H
#define CB_CMD_H

#include "config.h"
#include "debug.h"

void cmdBegin();     // 打印命令提示
void cmdPoll();      // 周期调用：读串口、解析、执行

#endif
