xdxfgc/chuan-bo-tong-xin/beidou_gps_test/config.h

/* =====================================================================
   config.h   全部可调参数
   ---------------------------------------------------------------------
   换接线、改参数只动这一个文件。
   所有用到的库也集中在这里 include：Arduino 的库发现机制有时扫不到
   「只被额外 .cpp 文件包含」的库，写在被 .ino 直接包含的头文件里最稳。
   ===================================================================== */

#ifndef CB_CONFIG_H
#define CB_CONFIG_H

#include <Arduino.h>
#include <WiFi.h>
#include <WebServer.h>
#include <Wire.h>
#include <SPI.h>
#include <VL53L1X.h>
#include <LoRa.h>

/* ---------------- 北斗定位模块 ATGM336H-5N（UART1） ----------------
   模块 TX -> GPIO17   模块 RX -> GPIO18   5V/GND
   接 ESP32 时模块上的 USB 口不要同时插电脑，那是同一路串口。        */
static const int      GPS_RX_PIN = 17;
static const int      GPS_TX_PIN = 18;
static const uint32_t GPS_BAUD   = 9600;

/* ---------------- 本船位置来源：手动坐标（室内演示用） ----------------
   为什么要这个：算信标方位、距离、搜索引导、态势图、岸基距离，
   都需要"本船在哪"。室内北斗定不上位，这些功能就全出不来。
   打开这个开关后，可以手动填一个本船坐标顶上：

     网页 ① 定位页签：填纬度/经度 → 点“设为手动坐标”
     串口：          pos 26.212676,111.599388   设定
                     pos auto                   切回北斗
                     pos                        看当前用的是哪个

   设定值存在 flash 里（和磁力计标定值一样），重启不丢。

   ⚠ 两点注意：
     1) 手动坐标期间走锚监测没法用 —— 位置不动，位移永远是 0。
        要测走锚先 `pos auto` 切回北斗。
     2) 演示时页面上会显示“位置来源：手动（模拟）”，
        别和真实定位混为一谈（文档里也要求“明确标注”）。

   默认关闭，不影响正常使用。                                         */
#define OWN_POS_ENABLE 1

/* ---------------- 激光测距 VL53L1X（I2C） ----------------
   VIN -> 3.3V（切勿接 5V）  GND -> GND  SCL -> GPIO22  SDA -> GPIO21 */
static const int TOF_SDA_PIN = 21;
static const int TOF_SCL_PIN = 22;
#define TOF_LONG_RANGE 1        // 1 = 远距模式（最远约 4 米），0 = 短距
/* 读取间隔：故意取 60，和传感器 startContinuous(50) 的 50 毫秒错开。
   两边节奏完全一样会"拍频"：每隔一轮就问空一次，而问空时并没有新数据，
   读数就会 50 毫秒一轮地闪成"无效"（OLED 上就是数字和无效来回跳）。
   错开之后每次问基本都有新数据。                                   */
#define TOF_READ_MS    60       // 读取间隔（毫秒）

/* 有效值保持窗口：读到一次好数据之后，这么久之内就算传感器还没出下一帧，
   也继续对外报这个值 —— 上一帧才旧了几十毫秒，完全能用。
   超过这个时间还没有新的有效读数，才真的判"无效"，并把失败原因带出去。
   这个值就是"允许多少个读取周期没有新数据"：400ms ÷ 60ms ≈ 6 轮。      */
#define TOF_VALID_HOLD_MS 400

/* ---------------- 第二只激光测距 VL53L1X（装在右舷） ----------------
   装船侧、朝正侧方：船横过来贴码头时，测的是"船到码头"的横向距离，
   这才是真实船舶靠泊的方式（侧靠）。

   两只 VL53L1X 出厂地址都是 0x29，直接并到同一条总线上会互相打架，
   所以接法和第一只不一样，多一根 XSHUT 线：

     VIN -> 3.3V（切勿接 5V）   GND -> GND
     SDA -> GPIO21（和第一只并联）  SCL -> GPIO22（和第一只并联）
     XSHUT -> GPIO32          ← 就这一根是新的

   上电顺序（写死在 tofBegin 里，不要改）：
     按住右舷那只 -> 船头那只拿到 0x29 -> 把它改到 0x2A -> 放开右舷那只
   这样两只地址就分开了，各自都能读。                                   */
/* ⚠ 2026-10-09 起暂时停用右舷那只，先单路跑测试。
   改回 1 就恢复双路，接线不用动 —— 停用期间 GPIO32 会被钉在低电平，
   把右舷那只按在复位状态，免得它上电后抢 0x29 和船头那只打架。 */
#define TOF_SIDE_ENABLE 0                // 1 = 双路（船头+右舷）  0 = 只用船头（停用右舷）
static const int     TOF2_XSHUT_PIN = 32;
static const uint8_t TOF_ADDR_BOW   = 0x2A;   // 船头那只改到 0x2A，把 0x29 让给右舷那只

/* ---------------- OLED 显示屏（SSD1306 128x64，I2C） ----------------
   和两只激光测距、MPU6050 共用一条 I2C 总线（21/22）：
   VL53L1X 右舷 = 0x29、VL53L1X 船头 = 0x2A、SSD1306 = 0x3C、MPU6050 = 0x68，
   地址各不相同，挂在一起互不冲突。
   VCC -> 3.3V   GND -> GND   SDA -> GPIO21   SCL -> GPIO22          */
static const int      OLED_SDA_PIN    = 21;
static const int      OLED_SCL_PIN    = 22;
static const uint8_t  OLED_ADDR       = 0x3C;   // 少数模块是 0x3D，读不出就改这里
static const uint32_t OLED_REFRESH_MS = 250;    // 两次刷屏的最短间隔

/* ---------------- MPU6050 六轴姿态（I2C） ----------------
   和两只激光、OLED 共用一条 I2C 总线：0x29 / 0x2A / 0x3C / 0x68 四个地址互不冲突。
   VCC -> 3.3V   GND -> GND   SDA -> GPIO21   SCL -> GPIO22
   AD0 -> GND 或不接（地址 0x68）；AD0 接高电平则变成 0x69。
   ⚠ MPU6050 没有磁力计：俯仰和横滚准，偏航会随时间漂。          */
static const uint8_t  IMU_ADDR    = 0x68;
static const uint32_t IMU_READ_MS = 20;         // 读取间隔（50Hz，对应文档采集频率）

/* ---------------- 磁力计 GY-282 / HMC5983（单独一路 I2C） ----------------
   单独走 Wire1（GPIO25/26），和激光/OLED/MPU6050 那条（Wire，21/22）分开：
   各用各的硬件控制器、时钟和总线复位，磁力计这边自动降速也不会拖累激光。
   VCC -> 3.3V   GND -> GND   SDA -> GPIO25   SCL -> GPIO26
   想省一对脚：把 I2C_BUS_INDEX 改成 0、SDA/SCL 改成 21/22，
   地址 0x1E 与 0x29 / 0x3C / 0x68 不冲突。                          */
#define I2C_BUS_INDEX   1        // 1 = Wire1（磁力计单独一路，默认）  0 = Wire（与激光共用）
#define I2C_SDA         25
#define I2C_SCL         26
#define I2C_HZ          50000UL  // 先跑 50kHz 求稳；代码会按上升时间自动降速
#define MAG_ADDR        0x1E     // HMC5983 固定地址（与 HMC5883L 相同）

/* HMC5983 参数（上电先从 flash 读，没有才用这里的默认值） */
#define MAG_AVG         1        // 平均次数：0=1次 1=2 2=4 3=8
#define MAG_RATE        6        // 输出速率：0=0.75Hz 1=1.5 2=3 3=7.5 4=15 5=30 6=75 7=220
#define MAG_GAIN        1        // 量程：0=±0.88Ga 1=±1.3 2=±1.9 3=±2.5 4=±4.0 5=±4.7 6=±5.6 7=±8.1
#define MAG_MODE        0        // 0=连续测量（实测失败率比单次低）
#define MAG_READ_MS     50UL     // 最快多久读一帧
#define MAG_EMA_ALPHA   0.30f    // 航向平滑系数：大=跟手但抖，小=稳但迟
#define MAG_DECL_DEG    0.0f     // 磁偏角（真北修正），长沙一带约 -5
#define MAG_TEMP_ENABLE 0        // 读片上温度（实验性）
#define MAG_TEMP_OFFSET_C 0.0f
#define MAG_CAL_DEFAULT_SEC  15  // 标定默认秒数
#define MAG_CAL_MIN_RANGE_UT 8.0f

/* ---------------- 板载 BOOT 按键（GPIO0） ----------------
   短按：把当前船头朝向设为出发点（0°）
   长按 3 秒：开始磁力计标定（拿起来绕「8」字慢慢转）
   不想用就把 BTN_ENABLE 改成 0。                                    */
#define BTN_ENABLE      1
#define BTN_PIN         0
#define BTN_ACTIVE_LOW  1
#define BTN_DEBOUNCE_MS 30
#define BTN_LONG_MS     3000
#define BTN_CAL_SECONDS 15

/* ---------------- 靠泊辅助（只用激光测距，不需要额外硬件） ----------------
   靠近到 BERTH_ENTER_M 以内自动开始监测，退出时用 BERTH_EXIT_M 做滞回。
   阈值按文档附录 B 的告警码取值，实测觉得太敏感或太迟钝就改这里。        */
#define BERTH_ENABLE 1

/* 靠泊判断用哪一路激光：
     0 = 自动（推荐）：右舷那只有效且进了靠泊区就用右舷，否则用船头
     1 = 固定用船头（顶着靠）
     2 = 固定用右舷（侧靠）
   自动模式的意义在于：顶着靠和侧靠两种演示都不用改代码。            */
#define BERTH_SRC_AUTO 0
#define BERTH_SRC_BOW  1
#define BERTH_SRC_SIDE 2
#define BERTH_SRC_MODE BERTH_SRC_AUTO

static const float BERTH_ENTER_M     = 3.5f;    // 进入监测的距离（激光量程 4 米，留余量）
static const float BERTH_EXIT_M      = 3.8f;    // 退出监测的距离（滞回 0.3 米）
static const uint32_t BERTH_EXIT_MS  = 3000;    // 超过退出距离要持续这么久才结束

static const float BERTH_SPEED_WARN  = 0.15f;   // 0x01 接近速度偏大（提醒级）
static const float BERTH_SPEED_ALARM = 0.30f;   // 0x02 接近速度过大（严重级）
static const float BERTH_NEAR_M      = 0.50f;   // 0x03 距岸过近的距离条件
static const float BERTH_NEAR_SPEED  = 0.10f;   // 0x03 距岸过近的速度条件

/* 告警的解除阈值（滞回）：触发用上面那组数字，解除用下面这组，两者留约 10% 的差。
   如果触发和解除用同一个数，速度正好在阈值上下浮动时，蜂鸣器会一秒响一次停一次
   地“哒哒”跳；留出差值之后就不会了。 */
static const float BERTH_SPEED_WARN_OFF  = 0.13f;   // 0x01 解除：速度降到这里以下
static const float BERTH_SPEED_ALARM_OFF = 0.27f;   // 0x02 解除
static const float BERTH_NEAR_M_OFF      = 0.55f;   // 0x03 解除：距离回升到这里以上
static const float BERTH_NEAR_SPEED_OFF  = 0.09f;   // 0x03 解除：速度降到这里以下

static const float BERTH_DONE_M        = 1.00f; // 靠妥判定：距离要小于这个
static const float BERTH_DONE_SPEED    = 0.03f; // 靠妥判定：速度要小于这个
/* 靠妥判定的辅助条件：观察窗内的极差要小于这个值。
   主判据是上面的速度，极差只用来挡住“一个大浪把船推了一截”。
   原来取 0.03 太严：3.2 秒内变化 3 厘米相当于 0.01 m/s，比速度阈值还严三倍，
   水面上的船一直在晃，永远达不到；放宽到 0.08 才能容忍正常的波浪起伏。 */
static const float BERTH_DONE_STEADY_M = 0.08f;
static const uint32_t BERTH_STEADY_MS  = 3000;  // 靠妥判定与静默共用的观察窗

/* 靠妥判定的三道防护：防止"一开机就在近处"被误判成刚刚靠好 */
static const uint32_t BERTH_MIN_WATCH_MS   = 2000;   // 进入监测后至少观察这么久
static const float    BERTH_APPROACH_MIN_M = 0.30f;  // 必须实际接近过这么多米

/* 靠妥后又离开岸壁：距离超过这个值并持续一段时间，就解除"已靠妥" */
static const float    BERTH_UNDOCK_M       = 1.50f;
static const uint32_t BERTH_UNDOCK_MS      = 1000;
static const float    BERTH_SCREEN_SPEED   = 0.01f;  // 移动超过这个速度才占用屏幕

/* 静默判据：拟合速度小于它就暂停念距离。
   用速度而不是极差——船靠在码头边随浪起伏时距离一直在变，极差永远超标，
   于是每 2 秒念一次没完没了；而浪造成的往复平均速度接近零，用速度就能安静下来。 */
static const float BERTH_QUIET_SPEED   = 0.02f;
static const uint32_t BERTH_ALARM_GAP_MS = 3000; // 告警播报最短间隔

/* 距离播报的"变化门槛"：距离只挪了一点点就别开口。
   船慢慢蹭着靠过去的时候，2 秒一次的播报会把话说得比念得还快，
   上一句还没念完下一句就来了 —— 加了这个门槛，说话次数能少一半。
   嫌报得太少就调小（0.2），嫌太吵就调大（0.5）。                */
static const float BERTH_ANNOUNCE_STEP_M = 0.30f;

static const uint8_t BERTH_DEBOUNCE_N  = 3;     // 告警去抖：连续多少帧满足才置位

/* 靠泊距离曲线（文档表20 要求"态势视图显示靠泊距离曲线"）
   每秒记一个点，90 个点 = 最近 1.5 分钟，网页上画成曲线。
   无效读数记 -1，画图时断开，不会把曲线连成假的。            */
#define BERTH_HIST_N   90
#define BERTH_HIST_MS  1000UL

/* ---------------- LoRa SX1278（433MHz，SPI） ----------------
   SCK->GPIO14  MISO->GPIO19  MOSI->GPIO23  NSS->GPIO13  RST->GPIO27
   DIO0 不接：程序用轮询，不需要中断脚。
   两块板子的射频参数必须完全一致，否则收不到。
   注意：这组引脚和接收端工程（WROOM32D_Coord_Receiver）一致，是按现有接线来的。
   如果以后换成 ESP32-S3，GPIO19 是 USB 脚、GPIO23 不存在，那时要改到
   12/13/27/32 一组上。                                              */
static const int  LORA_SCK_PIN  = 14;
static const int  LORA_MISO_PIN = 19;
static const int  LORA_MOSI_PIN = 23;
static const int  LORA_NSS_PIN  = 13;
static const int  LORA_RST_PIN  = 27;
static const int  LORA_DIO0_PIN = -1;
static const long RF_FREQ = 433E6;
static const int  RF_SF   = 10;
static const long RF_BW   = 125E3;
static const int  RF_SYNC = 0x12;

/* ---------------- 链路身份与定期广播 ----------------
   DEV_ID 是本机在无线链路里的标识：船端用 1，信标用 11 / 12 / 13……
   岸基节点靠它区分"这一帧是谁发的"。
   船端每 BROADCAST_MS 主动广播一帧自己的状态，岸基才有东西可收。      */
#define DEV_ID        1
/* 船端对岸基节点的广播节奏。
   原来固定 2 秒一帧，和信标 2 秒一次的 SOS 上报正好同拍；而发射时本机是收不到
   东西的（半双工），会把信标的包顶掉、逼它重传。
   现在分两种情况：
     · 信标不在线（超过 BROADCAST_QUIET_MS 没收到包）：每 BROADCAST_MS 发一帧
     · 信标在线：只挑「刚给信标回完 ACK、信标正处在自己那 2 秒静默期」的空档发，
       所以实际间隔约为 BROADCAST_MS 的 1~2 倍，永远不会压住 SOS            */
/* 三端同时工作时信道很挤（信标 + 船端 + 岸基都在发），所以放慢到 10 秒。
   岸基那边的"船端离线"判定已经跟着放宽到 30 秒，不会误报。          */
#define BROADCAST_MS          10000UL  // 两次广播最短间隔
/* 下面两个数字按空口时间算出来的，别乱改：
   SF10/BW125k 下一帧约 0.6~0.9 秒，本机回给信标的 ACK 大约在收包后 0.62 秒发完，
   信标下一帧在收包后约 3.2 秒才来。所以广播窗口取 0.8~1.6 秒最稳：
   既等 ACK 发完，又能在信标下一帧之前把 0.9 秒的广播发完。                   */
#define BROADCAST_SLOT_MIN_MS 800UL    // 收到信标包后至少等这么久（先让 ACK 发完）
#define BROADCAST_SLOT_MAX_MS 1600UL   // 超过这么久就不发，等下一个空档
#define BROADCAST_QUIET_MS    20000UL  // 这么久没收到信标，就按「信标不在线」处理

/* ---------------- SYN6288 语音模块（UART2） ----------------
   模块 RXD <- GPIO16（必接）  TXD -> GPIO4（可选）  VCC -> 5V      */
static const int      SYN_RX_PIN = 4;
static const int      SYN_TX_PIN = 16;
static const uint32_t SYN_BAUD   = 9600;
static const uint8_t  SYN_VOLUME = 8;

/* ---------------- 播报节奏 ---------------- */
static const uint32_t LINK_LOST_MS        = 15000;  // 超时未收信标就播报失去联系
static const uint32_t SHORE_LOST_MS       = 15000;  // 超时未收岸基帧就算岸基离线（不播报）
static const uint32_t ANNOUNCE_MIN_GAP_MS = 8000;   // 两次播报最短间隔，避免语音排队
static const uint32_t ANNOUNCE_MAX_MS     = 20000;  // 坐标没变也最多 20 秒重播一次
static const float    ANNOUNCE_MIN_MOVE_M = 3.0f;   // 目标移动超过 3 米就重播

/* ---------------- WiFi ----------------
   小米路由器有两个 WiFi 名字：不带 _5G 的是 2.4GHz（ESP32 必需），
   带 _5G 的是 5GHz，连不上。                                        */
#define WIFI_SSID   "Xiaomi_AE4D"
#define WIFI_PASS   "123456780"
#define WEB_PORT    80

/* 固定 IP：1 = 用固定地址（网页地址不会变），0 = 由路由器自动分配。
   前三段要和路由器同网段，小米路由器一般是 192.168.31.x，网关 .1。 */
#define USE_STATIC_IP 1
#define STATIC_IP_A   192
#define STATIC_IP_B   168
#define STATIC_IP_C   31
#define STATIC_IP_D   200
#define STATIC_GW_A   192
#define STATIC_GW_B   168
#define STATIC_GW_C   31
#define STATIC_GW_D   1

/* 路由器连不上时自己开热点兜底，保证网页一定能打开 */
#define AP_FALLBACK 1
#define AP_SSID     "Beidou-GPS"
#define AP_PASS     "12345678"

/* ---------------- 演示模式：开机直接开热点，不连路由器 ----------------
   0 = 正常连路由器（连不上才自动开热点，原来的行为）
   1 = 强制热点：开机跳过路由器，直接开 Beidou-GPS 热点，地址固定 192.168.4.1

   现场演示用 1 最稳，因为它把路由器整个踢出局了：
     · 不用求人开路由器、不用知道路由器密码
     · 不怕"无线隔离"（设备之间不能互访）
     · 不怕固定 IP 被别人占用、不怕 2.4G/5G 混在一起
   手机连上 Beidou-GPS（密码 12345678），浏览器打开 http://192.168.4.1 即可。

   ⚠ 开了之后板子就不再接路由器了。想改回连路由器，改回 0 重新烧录即可，
      接线一根都不用动。
   ⚠ 船端和岸基各是一个热点，一部手机同一时间只能连一个 —— 想同时看两个
      页面，准备两台设备（手机看船端、笔记本看岸基）。                    */
#define FORCE_AP 1

/* ---------------- 调试串口（USB） ---------------- */
static const uint32_t DBG_BAUD = 115200;

/* ---------------- 蜂鸣器（有源，3.3V 供电） ----------------
   VCC -> 3.3V    GND -> GND    I/O -> GPIO33

   触发极性看手上的模块：
     MH-FMG：高电平触发（高响、低停）  → BUZZER_ACTIVE_LOW 设 0
     MH-FMD：低电平触发（低响、高停）  → BUZZER_ACTIVE_LOW 设 1

   注意：模块说明书里的示例写的是 GPIO27，但 27 已经被 LoRa 的 RST 占用了；
   GPIO33 完全空闲，没有任何特殊功能，用它最省心。                     */
#define BUZZER_ENABLE 1
#define BUZZER_PIN    33
#define BUZZER_ACTIVE_LOW 0    // 1 = MH-FMD（低电平触发）  0 = MH-FMG（高电平触发）

/* ---------------- TB6612 电机驱动（单路，A 通道） ----------------
   STBY 常开（直接接 3.3V），所以单片机只管 3 根线：

     TB6612          ESP32
     AIN1     ->     GPIO2
     AIN2     ->     GPIO15
     PWMA     ->     GPIO12      （LEDC 调速，5kHz）
     STBY     ->     3.3V        （常开，不用控制）
     VCC      ->     3.3V        （逻辑供电）
     VM       ->     电池正极     （电机电源 2.5~13.5V）
     GND      ->     GND         （必须和 ESP32 共地）
     AOUT1/2  ->     电机两极

   ⚠ 三条硬规矩：
     1) 电机电源和 ESP32 分开供、只共地。电机启动电流能到 1~2A，
        共用一路会直接把 ESP32 拉复位。
     2) VM 就近并 470µF 电解 + 0.1µF 陶瓷，吸掉换向火花和峰值。
     3) GPIO2 和 GPIO12 是启动配置脚，上电瞬间要是低电平 ——
        这两根线上**不要外接上拉电阻**（TB6612 的输入是高阻，本身没问题）。

   引脚不够时的两个腾法（写在 README 里）：
     · 语音 BY 从 GPIO5 挪到 GPIO34/35/36/39（只读脚）
     · 右舷激光不用时 TOF_SIDE_ENABLE 改 0，释放 GPIO32            */
#define MOTOR_ENABLE 1
static const int MOTOR_AIN1_PIN = 2;
static const int MOTOR_AIN2_PIN = 15;
static const int MOTOR_PWM_PIN  = 12;

static const uint32_t MOTOR_PWM_HZ    = 5000;    // 5kHz：电机平顺、耳朵也听不见
static const uint8_t  MOTOR_PWM_BITS  = 8;       // 占空比 0~255
static const float    MOTOR_DEADBAND  = 0.06f;   // 油门小于这个就当停车（免得起转嗡嗡响）
static const float    MOTOR_RAMP_PS   = 0.80f;   // 每秒最多变化多少油门（软启动/软停）
static const uint32_t MOTOR_REV_GAP_MS = 300;    // 换向前先停稳这么久，保护 H 桥和电机

/* 电机油门上限与靠泊联锁
   ——船模不需要跑快，所以平时也限速，避免"一不小心给满油门船就窜出去"：
     正常情况            → 上限 MOTOR_CAP_NORMAL（默认 30%）
     0x01 提醒级（速度偏大）→ 上限压到 MOTOR_BERTH_WARN_CAP（默认 10%）
     0x02 / 0x03 严重级   → 立即刹车并锁定，重新给油门才恢复
   设成 0 可以整体关掉"告警联锁"（提醒级限速与严重级刹车都失效），
   但正常上限仍然生效，改上限请调 MOTOR_CAP_NORMAL。 */
#define MOTOR_BERTH_LOCK_ENABLE 1
static const float MOTOR_CAP_NORMAL     = 0.30f;   // 正常情况下的油门上限
static const float MOTOR_BERTH_WARN_CAP = 0.10f;   // 靠泊提醒级（0x01）时的上限

/* 按"距岸距离"分档限速：越靠近岸，允许的油门越小。
   这是"自动收油"的主体——告警联锁只是兜底，正常靠泊应该靠这个慢下来，
   一路都不该碰到 0.15 / 0.30 那两条告警线。
   分档点对着 berth 模块已经在用的 3.5m 进入 / 1.0m 靠妥 / 0.5m 过近。 */
#define MOTOR_BERTH_CAP_ENABLE 1
static const float MOTOR_CAP_D1 = 3.0f;    // 距离档位（米）
static const float MOTOR_CAP_C1 = 0.30f;   // 3 米以上：正常 30%
static const float MOTOR_CAP_D2 = 2.0f;
static const float MOTOR_CAP_C2 = 0.20f;   // 2~3 米：20%
static const float MOTOR_CAP_D3 = 1.0f;
static const float MOTOR_CAP_C3 = 0.12f;   // 1~2 米：12%
static const float MOTOR_CAP_D4 = 0.5f;
static const float MOTOR_CAP_C4 = 0.08f;   // 0.5~1 米：8%，慢慢贴
static const float MOTOR_CAP_C5 = 0.00f;   // 0.5 米以内：直接收油停住

/* ---------------- 走锚监测（锚泊位移监测） ----------------
   靠好或抛锚稳定后，用网页上的“设基准”按钮把当前位置记为原点，之后持续监测位移。
   判定按文档附录 B：
     0x21 疑似走锚：位移超限并持续一段时间，提醒级
     0x22 走锚    ：位移持续增大且速率没有放缓，严重级

   ⚠ 北斗单点定位误差约 2.5 米，而阈值默认才 2 米，所以必须对**位置**做长时间
     平滑（不是对位移平滑——位移恒为正，平均会带正偏置），否则船没动噪声就把告警刷满。 */
#define ANCHOR_ENABLE 1

static const float    ANCHOR_DRIFT_M     = 2.00f;   // 位移阈值（文档默认 2 米）
static const float    ANCHOR_DRIFT_OFF_M = 1.80f;   // 解除阈值（滞回）
static const uint32_t ANCHOR_HOLD_MS     = 60000;   // 疑似走锚要持续这么久
static const float    ANCHOR_SLOPE_DRAG  = 0.020f;  // 位移增长率门限（米每秒），超过算“持续增大”
#define ANCHOR_SAMPLE_MS 2000UL                     // 采样间隔

#define ANCHOR_POS_N   15       // 位置平滑窗（15 × 2 秒 = 30 秒）
#define ANCHOR_HIST_N  30       // 位移历史（30 × 2 秒 = 60 秒）

/* 激光辅助：停靠在码头时，与岸壁距离的变化比 GNSS 灵敏得多（毫米级）。
   横向位移超过这个值并持续一段时间，也判疑似走锚。 */
static const float    ANCHOR_LASER_D_M   = 0.50f;
static const uint32_t ANCHOR_LASER_MS    = 10000;

static const uint32_t ANCHOR_REPEAT_MS   = 20000;   // 告警持续时的重播间隔

/* ---------------- 数据记录（黑匣子） ----------------
   每秒把一帧状态存进 RAM 环形缓冲，网页上可以下载 CSV、按时间轴回放。
   只占内存、不写 flash——flash 每秒写一次会磨损，而且本项目不需要长期脱机记录。
   容量 900 条 × 1 秒 ≈ 15 分钟，够一次靠泊或一次试验用。              */
#define LOGBOOK_ENABLE   1
#define LOGBOOK_CAPACITY 900        // 记录条数
static const uint32_t LOG_INTERVAL_MS = 1000;   // 采样间隔
#define LOG_SERIAL_CSV   0          // 1 = 每秒也往串口打一行 CSV（默认关，免得刷屏）

#endif
