xdxfgc/chuan-bo-tong-xin/beidou_gps_test/tof.cpp

/* =====================================================================
   tof.cpp   激光测距实现（船头 + 右舷 两路）
   ---------------------------------------------------------------------
   两只 VL53L1X 出厂地址都是 0x29，必须靠 XSHUT 把地址分开才能挂一条总线：
     1) 先把右舷那只按住（XSHUT 拉低 = 复位）
     2) 船头那只正常初始化，拿到默认地址 0x29
     3) 把船头那只改到 0x2A，让出 0x29
     4) 放开右舷那只，它回到 0x29，再初始化
   这四步必须在任何 I2C 操作之前做完，顺序也不能换。
   ===================================================================== */

#include "tof.h"

static VL53L1X  tofBow;                        // 船头那只
#if TOF_SIDE_ENABLE
static VL53L1X  tofSide;                       // 右舷那只
#endif

static bool     bowReady  = false;
static bool     bowValid  = false;
static uint16_t bowMm     = 0;
/* 下面三个是"为什么现在没有有效距离"的依据：
     bowGoodMs   —— 最近一次读到**有效**值的时刻（有效性的判断基准）
     bowResultMs —— 最近一次读到**结果**的时刻，成功失败都算（用来分辨"掉线"）
     bowFailSt   —— 最近一次失败的状态码（给 tofText() 解释原因用）      */
static uint32_t bowGoodMs   = 0;
static uint32_t bowResultMs = 0;
static uint8_t  bowFailSt   = 0;

static bool     sideReady = false;
static bool     sideValid = false;
static uint16_t sideMm    = 0;
static uint32_t sideGoodMs   = 0;
static uint32_t sideResultMs = 0;
static uint8_t  sideFailSt   = 0;

static unsigned long tofLastReadMs = 0;

/* 状态码用不到的几个值借过来表示"不是测量失败，是根本没出结果"。
   VL53L1X 的 RangeStatus 只占 0~10 附近，借用高位不会撞车。 */
#define TOF_ST_TIMEOUT  0xFE     // 读超时 / 读到 0 毫米

/* ==================== I2C 小工具（裸 Wire 操作） ====================
   为什么需要这些：VL53L1X 的 I2C 地址写进芯片就一直在，**不随 ESP32 复位恢复**。
   所以我们把船头那只改成 0x2A 之后，只要 ESP32 重启（按 EN、重新烧录、看门狗复位）
   而激光模块没断电，它就还停在 0x2A —— 下次开机代码去 0x29 找它，必然找不到，
   日志就会出现「船头初始化失败、右舷正常」。
   下面的函数用裸 I2C 直接跟 0x2A 说话，把它请回 0x29。              */

// 探一下某个地址有没有器件应答（只发地址，不读写寄存器，安全）
static bool busProbe(uint8_t addr) {
  Wire.beginTransmission(addr);
  return Wire.endTransmission() == 0;
}

// 把某只 VL53L1X 的地址改成 to（写寄存器 0x0001 即可，与库的 setAddress 等价）
static bool busSetAddress(uint8_t from, uint8_t to) {
  Wire.beginTransmission(from);
  Wire.write(0x00);              // 寄存器地址高字节
  Wire.write(0x01);              // 寄存器地址低字节 → 0x0001 = 器件地址寄存器
  Wire.write(to & 0x7F);
  return Wire.endTransmission() == 0;
}

// 把总线上真实存在的地址打印出来（初始化失败时用，一眼看出谁在谁不在）
static void busPrintDevices() {
  Serial.print("当前 I2C 总线上的器件：");
  uint8_t n = 0;
  for (uint8_t a = 1; a < 127; a++) {
    if (busProbe(a)) { Serial.printf("0x%02X ", a); n++; }
  }
  if (n == 0) Serial.print("一个都没有（供电/共地/SDA/SCL 要查）");
  Serial.println();
}

// 配置一只传感器：测距模式、时间预算、开始连续测量
static void tofConfig(VL53L1X& t) {
  t.setDistanceMode(TOF_LONG_RANGE ? VL53L1X::Long : VL53L1X::Short);
  t.setMeasurementTimingBudget(50000);
  t.startContinuous(50);
}

void tofBegin() {
  Wire.begin(TOF_SDA_PIN, TOF_SCL_PIN);
  Wire.setClock(400000);

  /* 上电先把有效性证据全部清零：没有读到过好数据之前，对外一律"无效"，
     免得开机那一瞬间拿着默认值 0mm 冒充一次有效读数。 */
  bowValid = false;  bowMm = 0;
  bowGoodMs = bowResultMs = 0;  bowFailSt = 0;
  sideValid = false; sideMm = 0;
  sideGoodMs = sideResultMs = 0; sideFailSt = 0;

  /* 右舷那只先按住：把它的 XSHUT 拉低 = 复位，它就不会出现在总线上。
     TOF_SIDE_ENABLE == 1 时，这一步是为了先让船头那只拿到默认地址 0x29；
     TOF_SIDE_ENABLE == 0（右舷暂停）时，这一步是为了让它彻底别来抢 0x29 ——
     因为 VL53L1X 的 XSHUT 内部有上拉，悬空就等于"使能"，
     它会自己上电占住 0x29，把船头那只也带得读不出来。
     所以无论哪种模式，这一句都必须执行，只是后面放不放开的区别。 */
  pinMode(TOF2_XSHUT_PIN, OUTPUT);
  digitalWrite(TOF2_XSHUT_PIN, LOW);
  delay(20);

  /* 船头那只没有 XSHUT 线，ESP32 复位时它不跟着复位：
     上次被改成 0x2A 的地址会一直留着。这里先探一下，把它请回 0x29，
     否则下面的船头初始化必然失败（就是日志里那个现象）。
     ⚠ 两种模式都要做：右舷停用时，船头那只仍可能残留 0x2A。 */
  if (!busProbe(0x29) && busProbe(TOF_ADDR_BOW)) {
    Serial.printf("检测到船头那只还停在 0x%02X（上次运行残留的地址，芯片没断电不会自己复位），"
                  "正在改回 0x29…\n", TOF_ADDR_BOW);
    busSetAddress(TOF_ADDR_BOW, 0x29);
    delay(10);
  }

  /* ---- 船头那只 ---- */
  tofBow.setTimeout(500);
  if (!tofBow.init()) {
    bowReady = false;
    Serial.println("激光测距 VL53L1X（船头）初始化失败，按下面扫到的地址对号入座：");
    Serial.println("  只有 0x3C / 0x68（没有激光）→ 这只根本没上总线：VIN 要 3.3V、GND 共地、"
                   "SDA=GPIO21、SCL=GPIO22 别接反");
    Serial.println("  有 0x2A 却没能自动改回来 → 模块供电不稳 / 杜邦线接触不良");
    busPrintDevices();
  } else {
#if TOF_SIDE_ENABLE
    tofBow.setAddress(TOF_ADDR_BOW);      // 让出 0x29 给右舷那只
    delay(10);
#endif
    tofConfig(tofBow);
    bowReady = true;
    Serial.printf("激光测距（船头）已启动：SDA=GPIO%d SCL=GPIO%d 地址 0x%02X  %s模式\n",
                  TOF_SDA_PIN, TOF_SCL_PIN, tofBow.getAddress(),
                  TOF_LONG_RANGE ? "远距" : "短距");
  }

#if TOF_SIDE_ENABLE
  /* ---- 右舷那只：放开复位，它回到默认 0x29 ---- */
  digitalWrite(TOF2_XSHUT_PIN, HIGH);
  delay(20);
  tofSide.setTimeout(500);
  if (!tofSide.init()) {
    sideReady = false;
    Serial.println("激光测距 VL53L1X（右舷）初始化失败：先查 XSHUT 有没有接 GPIO32、"
                   "SDA/SCL 有没有和船头那只并联、VIN 是不是 3.3V。");
    busPrintDevices();
  } else {
    tofConfig(tofSide);
    sideReady = true;
    if (bowReady)
      Serial.printf("激光测距（右舷）已启动：地址 0x%02X（船头那只在 0x%02X，两路都在）\n",
                    tofSide.getAddress(), tofBow.getAddress());
    else
      Serial.printf("激光测距（右舷）已启动：地址 0x%02X（船头那只这次没起来）\n",
                    tofSide.getAddress());
  }
#endif
}

void tofUpdate() {
  if (millis() - tofLastReadMs < TOF_READ_MS) return;
  tofLastReadMs = millis();

  if (bowReady) {
    /* 读之前先问一句"这次测好了吗"。非阻塞读遇到"还没测好"会直接返回 0，
       而 ranging_data.range_status 还留着上一次的值（通常正好是"正常"），
       于是 0 毫米会被当成一次真读数，串口上就出现「0 mm (0.00 m)」。
       VL53L1X 的盲区是 4 厘米，0 毫米一定是无效值，这里两道都挡上。

       ⚠ 关键改动：没出新数据时**什么都不做**，保留上一次的值。
       以前这里直接写 bowValid = false，等于把"还没轮到出新数据"
       当成"测不到"，读数就会一轮一轮地闪成无效。              */
    if (tofBow.dataReady()) {
      uint16_t d = tofBow.read(false);
      bowResultMs = millis();
      if (tofBow.timeoutOccurred() || d == 0) {
        bowFailSt = TOF_ST_TIMEOUT;
      } else if (tofBow.ranging_data.range_status == VL53L1X::RangeValid) {
        bowMm    = d;
        bowFailSt = VL53L1X::RangeValid;
        bowGoodMs = millis();
      } else {
        bowFailSt = tofBow.ranging_data.range_status;
      }
    }
    /* 有效性只在"保持窗口"上判定：窗口内读到过有效值就一直有效。 */
    bowValid = (bowGoodMs != 0) && (millis() - bowGoodMs <= TOF_VALID_HOLD_MS);
  }

#if TOF_SIDE_ENABLE
  if (sideReady) {
    if (tofSide.dataReady()) {          // 同上：没新数据就保留上一次的值
      uint16_t d = tofSide.read(false);
      sideResultMs = millis();
      if (tofSide.timeoutOccurred() || d == 0) {
        sideFailSt = TOF_ST_TIMEOUT;
      } else if (tofSide.ranging_data.range_status == VL53L1X::RangeValid) {
        sideMm    = d;
        sideFailSt = VL53L1X::RangeValid;
        sideGoodMs = millis();
      } else {
        sideFailSt = tofSide.ranging_data.range_status;
      }
    }
    sideValid = (sideGoodMs != 0) && (millis() - sideGoodMs <= TOF_VALID_HOLD_MS);
  }
#endif
}

bool     tofIsReady()    { return bowReady; }
bool     tofIsValid()    { return bowValid; }
uint16_t tofDistanceMm() { return bowMm; }

/* 把"测距失败原因"翻译成人话 —— 直接告诉你该往哪个方向查。
   状态码来自 VL53L1X 库的 RangeStatus 枚举。                        */
static const char* tofFailReason(uint8_t st) {
  switch (st) {
    case VL53L1X::RangeValid:                return "正常";
    case VL53L1X::SigmaFail:                 return "信号弱：目标太远、太黑，或环境光太强";
    case VL53L1X::SignalFail:                return "回波太弱：目标太黑/太斜，或镜头脏了";
    case VL53L1X::RangeValidMinRangeClipped: return "贴在最小量程边上（约 4cm）";
    case VL53L1X::OutOfBoundsFail:           return "超出量程：目标太远（>4m）或没有反射面";
    case VL53L1X::HardwareFail:              return "硬件故障：传感器可能坏了";
    case VL53L1X::RangeValidNoWrapCheckFail: return "正常（未做缠绕检查）";
    case VL53L1X::WrapTargetFail:            return "相位缠绕：目标太远";
    case VL53L1X::XtalkSignalFail:           return "串扰：镜头前面有东西挡着";
    case VL53L1X::SynchronizationInt:        return "同步中断（刚启动那一下，忽略即可）";
    case VL53L1X::MinRangeFail:              return "目标太近（小于 4cm）";
    default: {
      static char b[24];
      snprintf(b, sizeof(b), "未知状态 %u", (unsigned)st);
      return b;
    }
  }
}

/* 现在没有有效距离，是"根本没出结果"还是"测了但没测到"？
   这两种要分开说，否则会把"线松了"误判成"激光坏了"：
     · 连结果都很久没出来 → 传感器卡住或掉线，查供电和接线
     · 有结果但状态不对   → 目标或环境问题，状态码已经说明了原因
   返回 nullptr 表示"最近有结果"，调用方就用状态码去解释。 */
static const char* tofStaleReason(uint32_t resultMs) {
  if (resultMs == 0 || (millis() - resultMs) > TOF_VALID_HOLD_MS)
    return "传感器一直没有新数据：查 VIN=3.3V、GND 共地、SDA/SCL 接触";
  return nullptr;
}

uint8_t tofFailCode() { return bowFailSt; }

/* 这次没读数，是不是"看不到东西"（太远 / 没有反射面）？

   为什么要单独拎出来：VL53L1X 对着远处的空处时，返回的状态码本来就不是
   RangeValid，而是下面这几个之一 —— 它并没有坏，只是前面没东西。
   现场看屏幕的人看到"无效"两个字，第一反应是设备坏了，所以这类情况
   干脆什么都不显示，屏幕上留白更干净。

   两类**不算**"看不到东西"，仍然要让它们显示出来：
     · 传感器连结果都不出了（掉线/供电不稳）→ tofStaleReason 有话说
     · 目标太近、硬件故障等其它状态码      → 状态码自己会解释
   这样"该干净的时候干净，该提醒的时候提醒"。 */
bool tofOutOfRange() {
  if (bowValid) return false;                      // 有有效距离，谈不上"看不到"
  if (tofStaleReason(bowResultMs)) return false;   // 连结果都没有 = 掉线，必须显示
  switch (bowFailSt) {
    case VL53L1X::SigmaFail:       // 信号弱：目标太远、太黑，或环境光太强
    case VL53L1X::SignalFail:      // 回波太弱：目标太黑/太斜，或没有反射面
    case VL53L1X::OutOfBoundsFail: // 超出量程：目标太远（>4m）或没有反射面
    case VL53L1X::WrapTargetFail:  // 相位缠绕：目标太远
      return true;
    default:
      return false;
  }
}

String tofText() {
  if (!bowReady) return "模块未连接";
  if (!bowValid) {
    char b[160];
    const char* why = tofStaleReason(bowResultMs);
    snprintf(b, sizeof(b), "无效（%s）",
             why ? why : tofFailReason(bowFailSt));
    return String(b);
  }
  char b[32];
  snprintf(b, sizeof(b), "%u mm (%.2f m)", (unsigned)bowMm, bowMm / 1000.0);
  return String(b);
}

#if TOF_SIDE_ENABLE
bool     tofSideIsReady()    { return sideReady; }
bool     tofSideIsValid()    { return sideValid; }
uint16_t tofSideDistanceMm() { return sideMm; }

String tofSideText() {
  if (!sideReady) return "模块未连接";
  if (!sideValid) {
    char b[160];
    const char* why = tofStaleReason(sideResultMs);
    snprintf(b, sizeof(b), "无效（%s）",
             why ? why : tofFailReason(sideFailSt));
    return String(b);
  }
  char b[32];
  snprintf(b, sizeof(b), "%u mm (%.2f m)", (unsigned)sideMm, sideMm / 1000.0);
  return String(b);
}
#else
bool     tofSideIsReady()    { return false; }
bool     tofSideIsValid()    { return false; }
uint16_t tofSideDistanceMm() { return 0; }
String   tofSideText()       { return "已暂停（config.h 里 TOF_SIDE_ENABLE = 0）"; }
#endif

void tofPrintReport() {
  Serial.printf("激光前方 : %s\n", tofText().c_str());
#if TOF_SIDE_ENABLE
  Serial.printf("激光右舷 : %s\n", tofSideText().c_str());
#endif
}

/* ==================== 自检（串口输入 tof 触发） ====================
   一路读 5 次，每次把「距离 / 状态 / 回波强度 / 环境光」全打出来。
   为什么要看后面两个数：它们是芯片自己量到的光强，
     · 超时             → 芯片根本没测完一次，不是"看不到东西"，是它没在干活
     · 回波强度 ≈ 0     → 光发出去没回来：镜头被挡、保护膜没撕、对着水面或空处
     · 环境光很大       → 太亮，挪开阳光或射灯
   "测不到"到底怪谁，看这两个数就分得清了。                                */
static void tofSelfTestOne(VL53L1X& t, const char* name, bool ready) {
  Serial.printf("【%s】", name);
  if (!ready) {
    Serial.println("没起来：芯片不应答。查 VIN=3.3V、GND 共地、SDA=GPIO21、SCL=GPIO22"
                   "（右舷那只还要查 XSHUT=GPIO32）");
    return;
  }

  Serial.printf("地址 0x%02X，读 5 次：\n", t.getAddress());
  for (int i = 1; i <= 5; i++) {
    t.setTimeout(150);
    uint16_t d = t.read(true);                       // 阻塞读，最多等 150ms
    if (t.timeoutOccurred())
      Serial.printf("  %d) 超时：150 毫秒都没测完一次 —— 芯片没在正常测距\n", i);
    else
      Serial.printf("  %d) %u mm  状态：%s  回波 %.2f MCPS  环境光 %.2f MCPS\n",
                    i, (unsigned)d, tofFailReason((uint8_t)t.ranging_data.range_status),
                    t.ranging_data.peak_signal_count_rate_MCPS,
                    t.ranging_data.ambient_count_rate_MCPS);
    delay(60);
  }
}

void tofSelfTest() {
  Serial.println("=========== 激光测距自检 ===========");
  tofSelfTestOne(tofBow, "船头", bowReady);
#if TOF_SIDE_ENABLE
  tofSelfTestOne(tofSide, "右舷", sideReady);
#else
  Serial.println("【右舷】未启用（config.h 里 TOF_SIDE_ENABLE = 0）");
#endif
  Serial.println("====================================");
}
