xdxfgc/chuan-bo-tong-xin/beidou_gps_test/beacon.cpp

/* =====================================================================
   beacon.cpp   信标接收与搜索引导实现
   ===================================================================== */

#include "beacon.h"
#include "gnss.h"
#include "ownpos.h"     // 本船位置来源（北斗 / 手动坐标）
#include "lora_link.h"
#include "voice.h"
#include "mag.h"

/* ---------------- 方位与距离解算（球面公式） ---------------- */

static const char* const GEO_DIR_UTF8[8] = { "正北", "东北", "正东", "东南", "正南", "西南", "正西", "西北" };

// 相对船头的八个方位：0 正前方 1 右前方 2 正右方 3 右后方 4 正后方 5 左后方 6 正左方 7 左前方
static const char* const GEO_REL_UTF8[8] = { "正前方", "右前方", "正右方", "右后方",
                                             "正后方", "左后方", "正左方", "左前方" };

static double toRad(double d) { return d * M_PI / 180.0; }
static double toDeg(double r) { return r * 180.0 / M_PI; }

// 两点间大圆距离（米）
static double geoDistanceM(double lat1, double lon1, double lat2, double lon2) {
  const double R = 6371000.0;
  double p1 = toRad(lat1), p2 = toRad(lat2);
  double dp = toRad(lat2 - lat1);
  double dl = toRad(lon2 - lon1);
  double a = sin(dp / 2) * sin(dp / 2) + cos(p1) * cos(p2) * sin(dl / 2) * sin(dl / 2);
  if (a > 1.0) a = 1.0;
  return 2.0 * R * asin(sqrt(a));
}

// 从点 1 指向点 2 的方位角（度，0 = 正北，顺时针）
static double geoBearingDeg(double lat1, double lon1, double lat2, double lon2) {
  double p1 = toRad(lat1), p2 = toRad(lat2);
  double dl = toRad(lon2 - lon1);
  double y = sin(dl) * cos(p2);
  double x = cos(p1) * sin(p2) - sin(p1) * cos(p2) * cos(dl);
  double b = toDeg(atan2(y, x));
  if (b < 0) b += 360.0;
  return b;
}

// 方位角归到 8 个扇区：0 正北 1 东北 2 正东 3 东南 4 正南 5 西南 6 正西 7 西北
static int geoDirSector(double bearingDeg) {
  int s = (int)((bearingDeg + 22.5) / 45.0) % 8;
  if (s < 0) s += 8;
  return s;
}

static const char* geoDirText(int sector) {
  if (sector < 0 || sector > 7) return "--";
  return GEO_DIR_UTF8[sector];
}

// 把「相对船头的角度」归到八个扇区
static int relDirSector(float rel) {
  int s = (int)((rel + 22.5f) / 45.0f) % 8;
  if (s < 0) s += 8;
  return s;
}

/* ---------------- 状态 ---------------- */

static bool          s_linkUp        = false;
static unsigned long s_lastPacketMs  = 0;
static bool          s_hasTarget     = false;
static bool          s_targetValid   = false;
static uint32_t      s_targetSeq     = 0;
static int           s_targetId      = 0;      // 0 = 老格式帧没带编号
static bool          s_targetWater   = false;  // 信标的水感电极是否确认导通
static double        s_tLat = 0.0, s_tLon = 0.0;
static int           s_rssi = 0;
static float         s_snr  = 0.0f;

static bool          s_haveDir  = false;
static float         s_distM    = 0.0f;
static float         s_bearing  = 0.0f;
static int           s_sector   = 0;

static bool          s_useRel     = false;   // 是否能用相对船头方位
static float         s_relBearing = 0.0f;
static int           s_relSector  = 0;

static bool          s_announced      = false;   // 播报去重
static bool          s_reportedNoFix  = false;
static double        s_annLat = 0.0, s_annLon = 0.0;
static unsigned long s_lastAnnounceMs = 0;
static bool          s_lastHaveDir    = false;


/* 编号文字：信标用 11/12/13……，本板是 1；老格式帧不带编号，显示 “--” */
static char s_idText[8] = "--";

static void updateIdText(int id) {
  if (id <= 0) snprintf(s_idText, sizeof(s_idText), "--");
  else         snprintf(s_idText, sizeof(s_idText), "%d", id);
}

static bool          s_alarmActive = false;      // 落水告警活动（需人工确认）
static bool          s_acked       = false;      // 本次落水事件是否已确认
static bool          s_everLinked  = false;      // 上电以来是否收到过包

/* ---------------- 内部逻辑 ---------------- */

// 用本船坐标算到信标的方向与距离
static void refreshGeo() {
  s_haveDir = false;
  s_distM   = 0.0f;
  s_bearing = 0.0f;
  s_sector  = 0;
  s_useRel     = false;
  s_relBearing = 0.0f;
  s_relSector  = 0;

  /* 本船位置统一从 ownpos 取：默认是北斗，室内演示时可能是手动坐标 */
  if (s_hasTarget && s_targetValid && ownPosValid()) {
    double mLat = ownPosLat();
    double mLon = ownPosLon();
    s_distM   = (float)geoDistanceM(mLat, mLon, s_tLat, s_tLon);
    s_bearing = (float)geoBearingDeg(mLat, mLon, s_tLat, s_tLon);
    s_sector  = geoDirSector(s_bearing);
    s_haveDir = true;

    // 相对船头：需要磁力计在位、而且标定过，否则退回绝对方位播报
    if (magPresent() && magCalibrated()) {
      float rel = s_bearing - magHeadingDeg();
      while (rel < 0.0f)     rel += 360.0f;
      while (rel >= 360.0f)  rel -= 360.0f;
      s_relBearing = rel;
      s_relSector  = relDirSector(rel);
      s_useRel     = true;
    }
  }
}

// 播报去重：同一条坐标不反复念，否则移动目标会把语音队列堆爆
static void maybeAnnounce() {
  /* 人工确认过就别再念了。
     没有这一行的话，ANNOUNCE_MAX_MS（20 秒）一到就会重新播报一次，
     就算你在串口敲了 ack、蜂鸣器已经停了，语音还是会一直念下去。

     之所以不会漏掉下一次报警：链路失联时 beaconUpdate() 会把 s_acked
     复位，所以信标重新上线（新事件）之后照样会报警。               */
  if (s_acked) return;

  /* 落水是最高优先级：正在念的如果只是靠泊那种播报（距离 1 级、告警 2 级），
     直接顶掉它，人的安全最重要。只有正在念同为 3 级的话才等一等，
     免得两句话互相掐。

     为什么不用"voiceBusy() 就等着"：靠泊时距离播报每 3 秒一句、每句占线 3 秒，
     语音几乎一直忙，落水那句话会永远排不上队 —— 之前就是这么哑掉的。 */
  if (voiceBusyPrio() >= VOICE_PRIO_SOS) return;

  if (s_announced && (millis() - s_lastAnnounceMs < ANNOUNCE_MIN_GAP_MS)) return;

  bool first     = !s_announced;
  bool dirChange = (s_haveDir != s_lastHaveDir);
  bool moved     = s_announced && s_haveDir &&
                   geoDistanceM(s_annLat, s_annLon, s_tLat, s_tLon) >= ANNOUNCE_MIN_MOVE_M;
  bool timeout   = s_announced && (millis() - s_lastAnnounceMs >= ANNOUNCE_MAX_MS);

  if (!(first || dirChange || moved || timeout)) return;

  voiceAnnounce(s_haveDir, s_tLat, s_tLon, s_distM,
                s_useRel ? s_relSector : s_sector, s_useRel);

  s_announced      = true;
  s_lastHaveDir    = s_haveDir;
  s_annLat         = s_tLat;
  s_annLon         = s_tLon;
  s_lastAnnounceMs = millis();
}

// 收到一包信标数据（由主程序按帧类型分发过来）
void beaconOnPacket(const TargetPacket& pkt) {
  bool wasDown = !s_linkUp;

  s_lastPacketMs = millis();
  s_linkUp       = true;
  s_everLinked   = true;

  // 先回 ACK，别被显示和播报拖慢
  loraSendAck(pkt.seq, ownPosValid(), ownPosLat(), ownPosLon());

  if (pkt.duplicate) {
    Serial.printf("[LoRa] 信标 %d #%lu 是重传包，已回 ACK（不重复播报）\n",
                  pkt.srcId, (unsigned long)pkt.seq);
    return;
  }

  s_hasTarget   = true;
  s_targetValid = pkt.valid;
  s_targetSeq   = pkt.seq;
  s_targetId    = pkt.srcId;
  updateIdText(pkt.srcId);
  // 老格式帧没有水感字段，当作"有水"，退回原来的报警行为
  s_targetWater = pkt.hasWater ? pkt.waterOn : true;
  s_tLat        = pkt.lat;
  s_tLon        = pkt.lon;
  s_rssi        = pkt.rssi;
  s_snr         = pkt.snr;

  Serial.printf("[LoRa] 收到信标 %d #%lu  定位=%s  %.6f, %.6f  RSSI=%d dBm  SNR=%.1f dB\n",
                pkt.srcId, (unsigned long)pkt.seq, pkt.valid ? "有效" : "无效",
                pkt.lat, pkt.lon, pkt.rssi, pkt.snr);

  if (wasDown && s_announced) voiceSpeakLinkBack();
  /* 链路恢复 = 上一次事件已经过去（信标睡过一觉或漂远过），
     播报状态清零，万一马上又落水，按新事件立刻重新播报。 */
  if (wasDown) s_announced = false;

  refreshGeo();

  /* 报警条件：
       带水感字段的帧（新格式）→ 只看水感位，**不要求坐标有效**
       不带水感字段的帧（老格式）→ 退回老行为：收到有效坐标就报警

     为什么新格式不能再要求坐标有效：
       信标平时深睡、北斗也是断电的，落水被唤醒后北斗要冷启动 30~60 秒。
       这半分钟里信标发的是 P,0,0,0 —— 如果报警还要求坐标有效，
       那最该报警的半分钟反而不响。方位距离等北斗定上位了自然会出来。 */
  bool waterAlarm = pkt.hasWater ? pkt.waterOn : s_targetValid;

  /* ---- 本次落水事件结束的判据：已确认过 + 信标这一帧报"没水" ----
     人已经离开水面了。把"已确认"和"已播报过"都清掉，
     这样下次真的再落水，能当成一个**新事件**立刻重新报警。

     为什么必须这么改：信标平时一直发心跳（8 秒一帧），链路根本不会断，
     而 s_acked 以前只在"链路失联"时才复位 —— 结果确认过一次之后，
     同一个信标整场演示只会响一次，除非重启板子。                  */
  if (s_acked && pkt.hasWater && !pkt.waterOn) {
    s_acked       = false;
    s_alarmActive = false;
    s_announced   = false;                 // 下次落水按"首次"处理，立刻播报
    Serial.println("[信标] 已离水，本次落水事件结束（再落水会重新报警）");
  }

  if (waterAlarm) {
    // 落水告警：置位后保持，直到人工确认；确认后同一个事件不再重复触发
    if (!s_acked) s_alarmActive = true;
    s_reportedNoFix = false;
    maybeAnnounce();
  } else if (!s_targetValid && !s_reportedNoFix) {
    s_reportedNoFix = true;
    voiceSpeakTargetNoPos();
  }
}

/* ---------------- 对外接口 ---------------- */

void beaconBegin() {
  s_linkUp = false;
  s_hasTarget = false;
  s_targetValid = false;
  s_targetId = 0;
  updateIdText(0);
  s_announced = false;
  s_reportedNoFix = false;
  s_haveDir = false;
}

void beaconUpdate() {
  /* 收包的活儿已经挪到主程序的 loraPollAll() 里统一分发（信标 M 帧给这里，
     岸基 R/A 帧给 shore 模块），这里只管信标自己的超时判断。          */
  // 链路超时：这里必须重新读一次 millis()。刚收到的包会把 s_lastPacketMs
  // 设成「比本轮 now 还新」的时刻，用旧值相减会变成无符号下溢，刚收到包就被误判。
  if (s_linkUp && (millis() - s_lastPacketMs > LINK_LOST_MS)) {
    s_linkUp = false;
    /* 失联视为本次事件结束：确认标志和播报状态都清零，
       信标重新上线后按新事件处理（不然恢复之后可能因为"已播报过"而漏报）。 */
    s_acked     = false;
    s_announced = false;
    Serial.println("[链路] 超过 15 秒没收到信标，播报失去联系");
    voiceSpeakLinkLost();
  }
}

void beaconPrintReport() {
  Serial.println("--------------- 信标链路 ---------------");
  Serial.printf("链路     : %s   RSSI %d dBm   SNR %.1f dB\n",
                s_linkUp ? "在线" : "离线", s_rssi, s_snr);
  if (s_hasTarget) {
    Serial.printf("信标编号 : %s（-- 表示老格式帧没带编号）\n", s_idText);
    Serial.printf("水感     : %s%s\n",
                  s_targetWater ? "导通（已确认入水）" : "未导通（正常值守）",
                  s_alarmActive ? "   ← 落水告警中" : "");
    Serial.printf("信标位置 : %s  #%lu  %.6f, %.6f\n",
                  s_targetValid ? "有效" : "未定位",
                  (unsigned long)s_targetSeq, s_tLat, s_tLon);
  } else {
    Serial.println("信标位置 : 还没收到数据");
  }
  if (s_haveDir) {
    if (s_useRel) {
      Serial.printf("搜索引导 : %s  约 %.0f 米（相对船头 %.0f 度 / 绝对 %.0f 度）\n",
                    GEO_REL_UTF8[s_relSector], s_distM, s_relBearing, s_bearing);
    } else {
      Serial.printf("搜索引导 : %s方向  约 %.0f 米（绝对方位 %.0f 度）\n",
                    geoDirText(s_sector), s_distM, s_bearing);
    }
  } else {
    Serial.println("搜索引导 : 等本船定位和信标坐标都有效后给出");
  }
  Serial.println("--------------------------------------");
}

bool        beaconLinkUp()      { return s_linkUp; }

/* 给「船端对外广播」让路用的：本机刚收完信标包之后的一小段时间里，
   信标正在等应答、然后进入它自己的静默期，这时候发广播最不容易撞。 */
uint32_t    beaconLastPacketAgeMs() {
  if (!s_everLinked) return 0xFFFFFFFFu;
  return (uint32_t)(millis() - s_lastPacketMs);
}

bool        beaconHasTarget()   { return s_hasTarget; }
bool        beaconTargetValid() { return s_targetValid; }
uint32_t    beaconSeq()         { return s_targetSeq; }
int         beaconId()          { return s_targetId; }
const char* beaconIdText()      { return s_idText; }
double      beaconLat()         { return s_tLat; }
double      beaconLon()         { return s_tLon; }
int         beaconRssi()        { return s_rssi; }
float       beaconSnr()         { return s_snr; }
bool        beaconHaveDir()     { return s_haveDir; }
float       beaconDistM()       { return s_distM; }
float       beaconBearing()     { return s_bearing; }
const char* beaconDirText()     { return s_haveDir ? geoDirText(s_sector) : "--"; }

bool        beaconUseRel()      { return s_useRel; }
float       beaconRelBearing()  { return s_relBearing; }
const char* beaconRelDirText()  { return s_useRel ? GEO_REL_UTF8[s_relSector] : "--"; }
float       beaconArrowBearing(){ return s_useRel ? s_relBearing : s_bearing; }

bool beaconAlarmActive() { return s_alarmActive; }
bool beaconEverLinked()  { return s_everLinked; }

void beaconAcknowledge() {
  s_alarmActive = false;
  s_acked       = true;
}
