xdxfgc/chuan-bo-tong-xin/beidou_gps_test/lora_link.h

/* =====================================================================
   lora_link.h   LoRa 链路（SX1278 433MHz）
   ---------------------------------------------------------------------
   注意：文件名不能用 lora.h。Windows 不区分文件名大小写，
   `#include <LoRa.h>`（库）会优先匹配到同目录的 lora.h，导致库加载失败。

   协议（和信标端 ESP32-C3、岸基节点三端一致）：
     信标 -> 所有（新）：M,<信标ID>,<序号>,P,<定位有效 0/1>,<纬度>,<经度>,
                          <水感 0/1>
     信标 -> 所有（老）：M,<序号>,P,<定位有效 0/1>,<纬度>,<经度>
     岸基 -> 所有：      R,<岸基ID>,<序号>,P,<岸基定位有效 0/1>,<纬度>,<经度>
     应答 -> 对方：      A,<自己ID>,<序号>,C,<自己定位有效 0/1>,<纬度>,<经度>
     本板 -> 所有：      S,<船ID>,<序号>,P,<本方定位有效 0/1>,<纬度>,<经度>,
                         <对地速度节>,<航向度>,<卫星数>

   本板收三种帧：
     M —— 落水信标（交给 beacon 模块）
     R / A —— 岸基节点（交给 shore 模块：R 是参考站广播，A 是岸基回信标的应答，
             两者都带着岸基自己的位置，都能当"岸基在哪"用）

   新老两种格式都认：老格式第 3 个字段直接是 "P"/"C"，新格式第 2 个字段是
   发送者编号。老格式帧的 srcId 记为 0。同一只发送者、同一序号的重传包会被
   标记为 duplicate——按"帧类型 + 发送者"分开记，多只信标同时工作不会互相误判。
   ===================================================================== */

#ifndef CB_LORA_LINK_H
#define CB_LORA_LINK_H

#include "config.h"

struct TargetPacket {
  char     kind      = 'M';     // 'M' = 信标帧   'R' / 'A' = 岸基帧
  int      srcId     = 0;       // 发送者标识（0 = 老格式，没有 ID）
  uint32_t seq       = 0;
  bool     valid     = false;   // 信标定位是否有效
  double   lat       = 0.0;
  double   lon       = 0.0;
  bool     duplicate = false;   // 与上一包同序号（信标没收到 ACK 重发的）
  int      rssi      = 0;
  float    snr       = 0.0f;

  /* 信标帧里多带的一个字段：水感电极是不是确认导通。
     信标现在"一直发"（链路随时在线），靠这个位告诉船端
     "我是真的入水了"还是"只是在正常值守"。
     老格式帧没这个字段，hasWater = false，船端按老规矩处理。 */
  bool     hasWater  = false;
  bool     waterOn   = false;
};

bool loraBegin();                 // 初始化射频，失败返回 false
bool loraIsReady();
bool loraPoll(TargetPacket* out); // 收到一包返回 true
void loraSendAck(uint32_t seq, bool centerValid, double lat, double lon);
// 船端定期广播自己的状态（岸基节点收这个）
bool loraSendShipStatus(bool valid, double lat, double lon,
                        float sogKnots, float cog, int sats);
int  loraChannelRssi();           // 信道底噪，用于判断射频是否正常工作

#endif
