xdxfgc/chuan-bo-tong-xin/beidou_gps_test/cmd.h

/* =====================================================================
   cmd.h   串口命令分发
   ---------------------------------------------------------------------
   一块程序里只有一个地方读串口，避免多个模块抢字符。
   负责：语音音量、磁力计标定/出发点/磁偏角/扫描、命令提示，
   以及标定过程的进度与结束提示。
   ===================================================================== */

#ifndef CB_CMD_H
#define CB_CMD_H

#include "config.h"

void cmdBegin();        // setup 里调一次：打印命令提示
void cmdPoll();         // loop 里每次调：读串口命令并执行
void cmdPollEvents();   // loop 里每次调：标定进度与结束提示
void cmdPrintMagLine(); // 打印一行磁力计状态（供每秒状态报告调用）

#endif
