xdxfgc/chuan-bo-tong-xin/beidou_gps_test/oled.h

/* =====================================================================
   oled.h   OLED 显示屏（SSD1306 128x64，I2C）
   ---------------------------------------------------------------------
   与激光测距共用 I2C 总线（SDA=21 / SCL=22），地址 0x3C 与 0x29 不冲突。
   有信标坐标时显示信标界面，没有时显示本船状态。
   ===================================================================== */

#ifndef CB_OLED_H
#define CB_OLED_H

#include "config.h"

void oledBegin();      // 初始化屏幕
void oledUpdate();     // 周期调用：到了刷新间隔就重画一屏

#endif
