xdxfgc/chuan-bo-tong-xin/(commit log)

2026-10-03 添加北斗定位服务器代码（ESP32-S3 + ATGM336H-5N）
    - 读取并解析 NMEA 定位数据，打印到串口监视器
    - 内置网页服务器，可实时查看经纬度、卫星数、位姿帧等信息
    - 优先接入路由器，连不上时自动切换为热点模式
2026-10-03 加入 VL53L1X 激光测距模块
    - 通过 I2C 读取测距数据（SDA=GPIO21，SCL=GPIO22）
    - 串口每秒打印激光距离，网页新增距离卡片，JSON 增加 tof 相关字段
    - README 补充接线、库安装和注意事项
2026-10-03 加入 LoRa 信标接收与 SYN6288 语音播报
    - 移植 SX1278 433MHz 收发与 ACK 应答，兼容信标端（ESP32-C3）协议
    - 新增方位解算：用本船北斗位置算出到信标的方向与距离
    - 新增 SYN6288 语音播报，含 GB2312 词表、播报节流与在线调音量
    - 网页新增信标链路、距离、方位卡片，收到落水信标时横幅置顶报警
    - README 补充接线、射频参数、库安装与协议说明
2026-10-03 加入 OLED 显示与 MPU6050 姿态
    - 新增 oled 模块：SSD1306 128x64，与激光共用 I2C 总线，信标/本船两种画面自动切换
    - 新增 imu 模块：MPU6050 六轴姿态，接同一条 I2C 总线（地址 0x68），50Hz 采集
    - 姿态数据接入串口、OLED 与网页（俯仰、横滚、温度）
    - README 补充接线、I2C 总线共用说明、程序空间提醒与偏航角限制
2026-10-03 整合磁力计 GY-282（航向）与板载按键
    - 移植 mag 模块：HMC5983 航向、硬磁/软磁标定、I2C 自恢复，独立走 Wire1（GPIO25/26）
    - 移植 button 模块：短按设出发点、长按开始标定，去掉对 console 模块的依赖
    - 新增 cmd 模块：统一串口命令入口（音量/标定/出发点/磁偏角/扫描），避免多处抢串口
    - 语音与 OLED 支持相对船头方位（左前方），磁力计未标定时自动退回绝对方位
    - 网页增加航向角与磁力计卡片，信标方位优先显示相对方向
    注意：本次提交尚未完成编译验证。
2026-10-04 加入靠泊辅助模块
    - 新增 berth 模块：距离 3 点中值 + 8 点平均滤波、0.4 秒窗口最小二乘拟合接近速度
    - 按文档附录 B 实现 0x01/0x02/0x03 三条告警，带 3 帧去抖
    - 距离分档播报（含厘米档与“即将靠妥”）、告警优先插播、停稳静默
    - 靠妥判定、OLED 靠泊画面、网页靠泊卡片与告警横幅、dock 串口命令
    - README 补充靠泊辅助章节与阈值说明
    已知问题（待修）：
    - 滤波窗口未填满时 calcSpeed()/winRange() 返回 0，被当成“速度为零、距离没变”，
    于是只要距离小于 1 米就会被误判为靠妥；
    - 开机时若激光正对 1 米以内的目标（实测 70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
    [beidou_gps_test.ino, berth.cpp, berth.h, cmd.cpp, config.h, gb2312_voice.h, net.cpp, oled.cpp]
2026-10-04 修复靠泊靠妥的误判
    现象：开机时若激光正对 1 米以内的目标（实测 70 厘米），约 100ms 内就被判定为“已靠妥”，
    屏幕一直显示“靠泊完成”，并顶掉信标与本船画面。
    根因：滤波窗口没填满时 calcSpeed() 与 winRange() 都返回 0，被当成“速度为零、距离没变”，
    于是只要距离小于 1 米，靠妥的三个条件就全部“成立”。
    修复：
    - calcSpeed() 要求拟合窗填满才输出；winRange() 在观察窗不足一半时返回大值，表示证据不足
    - 靠妥判定增加四道防护：窗口攒够样本、进入监测满 2 秒、实际接近过 30 厘米以上，
    靠妥后离开岸壁（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
    [berth.cpp, berth.h, config.h, oled.cpp]
2026-10-04 靠泊判据改为以速度为主，解决判不出靠妥与播报停不下来
    问题一：水面上的船一直在晃，靠妥判定要求“3.2 秒观察窗内极差小于 3 厘米”，
    相当于要求速度低于 0.01 m/s，比速度阈值 0.03 还严三倍，正常靠泊永远达不到。
    问题二：静默判据用的是“极差小于 5 厘米”，船靠在码头边随浪起伏时距离一直在变，
    该条件永不成立，于是每 2 秒念一次距离，停不下来。
    改动：
    - 靠妥判定的极差容差 0.03 → 0.08 米，放宽到能容忍正常波浪起伏；
    主判据仍然是拟合速度低于 0.03 m/s，极差只用来挡住“一个大浪把船推了一截”
    -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
    [berth.cpp, config.h]
2026-10-04 LoRa 引脚改为与现有接线一致（19/23/13/27）
    现象：LoRa 一直初始化失败、收不到任何包，导致所有依赖信标的语音播报（人员落水、
    信标未定位、失联与恢复）永远不会触发。
    原因：移植时为了兼容 ESP32-S3，把 LoRa 引脚从接收端工程的 14/19/23/13/27 改成了
    14/12/13/27/32（S3 上 19 是 USB 脚、23 不存在），但实际接线仍按原工程接的，
    两套引脚对不上，SPI 从一上电就没跑起来。
    - config.h：LORA_MISO 12→19、LORA_MOSI 13→23、LORA_NSS 27→13、LORA_RST 32→27，
    并在注释里说明这组引脚与接收端工程一致、将来换 S3 时要改回 12/13/27/32
    - l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
2026-10-04 加入蜂鸣器与走锚监测，网页改为标签页
    一、蜂鸣器（新增 buzzer 模块）
    - 接 GPIO33；支持高/低电平触发两种模块，config.h 里一个开关切换
    - 三级节奏：人员落水三短声急促循环、靠泊严重与走锚两短声、提醒级单短声每 2 秒
    - 网页上有开关可随时关闭；告警全部解除或出现更高等级告警时自动恢复
    - 落水告警需人工确认（串口 ack），确认后同一事件不再重复报警
    - 上电时先把输出电平设成“不响”再切换成输出，避免低电平触发的模块误响
    二、走锚监测（新增 anchor 模块）
    - 设基准后监测位移：对**经纬度**做 30 秒滑动平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
    [anchor.cpp, anchor.h, beacon.cpp, beacon.h, beidou_gps_test.ino, berth.cpp, buzzer.cpp, buzzer.h]
2026-10-04 加入信标工程 C3_Coord_Sender，仓库分为船端与信标两个文件夹
    - 新增 C3_Coord_Sender/：ESP32-C3 SuperMini + SX1278 坐标发送端
    - 模块化为 config / debug / coord / radio / link，主程序只做初始化与调度
    - 帧格式加发送者 ID：M,<信标ID>,<序号>,P,<有效>,<纬度>,<经度>
    - 应答解析兼容带 ID 与不带 ID 两种格式
    - 四种坐标来源：固定坐标 / 绕点漂移 / 本端北斗 / 串口手动输入
    - 已用 arduino-cli 编译验证四种配置全部通过
    - 根 README 重写：说明两个文件夹、两边协议与射频参数约定
2026-10-04 船端加本机标识与定期广播，修通信协议对不上信标的问题
    船端 beidou_gps_test：
    - LoRa 入帧解析改成新老格式都认。之前只认老格式 M,<序号>,P,...，
    信标发的新格式 M,<信标ID>,<序号>,P,... 会被当成无法解析的包丢掉，
    两边实际通不了
    - TargetPacket 加 beaconId；重传识别改成按发送者分开记（原来只记上一包
    序号，多只信标交替发会互相误判）
    - 应答帧带船 ID：A,<船ID>,<序号>,C,<有效>,<纬度>,<经度>
    - 新增 selfcast 模块：每 2 秒广播 S,<船ID>,<序号>,P,... 给岸基用
    - 信标编号显示到串口、OLED 和网页
    - config.h 加 DEV_ID=1 与 BOAT_BCAST_MS=2000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
    [beacon.cpp, beacon.h, beidou_gps_test.ino, config.h, debug.cpp, debug.h, link.cpp, lora_link.cpp]
2026-10-04 同步实际使用的船端代码，并补上信标编号显示
    上一轮“加发送者 ID 与定期广播”的改动只落在实际使用的代码目录里，没有进仓库，
    导致仓库副本和实际代码分叉成了两套并行实现。这次以实际使用的版本为准合并。
    - 撤掉仓库里那套并行实现（selfcast 模块），改用实际代码里的 loraSendShipStatus
    （S 帧还多带对地速度、航向、卫星数，对岸基更有用）
    - lora_link.cpp：重传识别改成按发送者分开记。原来只记上一包序号，
    多只信标交替发会被误判成重传
    - lora_link.cpp：别人的 S/A 帧不再打印“无法解析的包”，只对 M 帧报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
2026-10-05 信标北斗模块：补上失联超时、定位质量与状态提示
    - coord.cpp 模式 2 原来只读 GGA 的经纬度，模块拔掉之后 gValid 会一直停在
    true，信标会拿着过期坐标继续往外发。现在加 GNSS_STALE_MS（10 秒）超时
    - 读 GGA 第 7 字段定位质量、第 8 字段卫星数，只有质量 > 0 且坐标不是 (0,0)
    才算真的定上位
    - 每 5 秒打一行状态，把四种情况分开：一句数据都没收到 / 串口断了 /
    正在搜星 / 已定位。接线接反、没供电、天线位置不对能一眼看出来
    - 开机提示里加上接法提醒和冷启动时间预期
    - README 补上北斗接线表、GPIO20/21 为什么可以放心用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
2026-10-05 信标坐标来源切换为北斗模块（SRC_MODE 0 -> 2）
    - 信标不再发 config.h 里写死的固定坐标，改成读 GPIO20/21 上的北斗模块
    - 没定位时发 P,0,0,0（定位有效位为 0），船端显示“未定位”，
    但链路本身不受影响，只要收到帧就会显示在线
    - 顺便把 SRC_MODE 的注释更新：标明 0 发的是假坐标，以及怎么改回去
    模式 2 编译验证通过（337254 字节 / 25%）
2026-10-05 信标加入水感检测（落水触发）模块
    新增 water.h / water.cpp：
    - 两片不锈钢电极接 WATER_PIN_A / WATER_PIN_B（默认 GPIO3 / GPIO4），
    间距 3~5 毫米，不需要任何电阻电容
    - 平时两个脚都是高阻输入：零功耗、电极不带电，不腐蚀
    - 每 WATER_SAMPLE_MS(500ms) 采样一次，每次两个方向各测一遍
    （A 输出低 B 开上拉读，再反过来），电流方向交替，抑制电极电解腐蚀
    （文档表 18 说的"间歇通电采样"）
    - 临时测试不用做电极：两根杜邦线插这两个脚，线头碰一起就是"入水"，
    走的电路和真电极一样，以后换真电极代码不用改
    - 串口模拟命令 we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
2026-10-05 信标：补上三重确认里的“持续时间”，并切换到落水才上报的演示配置
    之前 WATER_CONFIRM_MS 只定义了、从来没被使用过。主程序只判断“有没有水”，
    所以线头碰一下（哪怕 1 毫秒）信标立刻就开始上报 —— 三重确认里
    “持续时间”这一条实际是空的。
    - 主程序改成 waterIsWet() && waterWetMs() >= WATER_CONFIRM_MS，
    “持续时间”真正生效
    - 加上状态提示：确认落水时打印“连续湿 N 秒，开始上报”，
    离水时打印“已离水，恢复静默”
    - SEND_ONLY_WET 改为 1（平时静默、入水才上报）
    - SRC_MODE 改为 0（室内演示先用固定坐标，北斗模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
2026-10-05 信标：接入姿态传感器，三重确认完整落地（水感 + 姿态 + 持续时间）
    新增 posture（MPU6050 姿态判定）：
    - 接 I2C GPIO0/GPIO1，A0 接 GND（地址 0x68）
    - 上电时连续采 20 次取平均当基准姿态。必须相对基准判断，不能用绝对
    角度 —— 救生衣的佩戴方向每个人不一样
    - 三条子判据：
    ① 先失重（<0.6g）再冲击（>2.0g），800ms 窗口
    ② 相对基准转过 55° 以上
    ③ 运动（半秒峰峰值）<0.30g，即"平静"
    - 另外算摇摆频率，但**只打印不判定**：频率需要 8 秒窗口才算准，
    和文档"3 秒内激活"冲突
    新增 trigger（落水激活状态机）：
    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
2026-10-05 网页加信标相对态势图，并把数据记录与回放一并入库
    现象：
    - 页面上只有“信标 123 米 · 东北”这样的文字，落水搜救时得自己在脑子里把它
    转成水面上的相对位置，边操船边判断很吃力。
    - 上一版做好的数据记录与回放（logbook）还只在本机，没有入库。
    根因 / 做法：
    - 网页 ⑥ 信标 标签页新增 canvas 俯视态势图：本船固定在圆心（蓝色三角指船首），
    信标是红点带呼吸圈，两点间虚线标注距离与方位，同心圆是自动分档的距离圈，
    橙色线是本船航迹，另有“清除航迹”按钮。
    - 视图可切“船头朝上 / 正北朝上”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
2026-10-06 三端齐了：新增岸基节点工程，船端加“岸基跟踪”模块
    新增 shore_base_node/（岸基节点 / 港口端）：
    - 从旧的单文件版本整理成模块化工程，协议升级到三端统一的新版本
    - 岸基广播改用 R 前缀（原来用 S，和船端的 S 本船广播撞车）
    - 信标按编号分槽位（最多 4 只），多只信标不会互相覆盖
    - 重传识别按“帧类型 + 发送者”分开记。原来只分信标/船端两类，
    - 网页新增“信标编号”“在线信标数”两张卡片
    - 顺带去掉压缩包里带的 build/ 编译产物
    船端加“岸基跟踪”：
    - 新增 shore.h / shore.c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
2026-10-06 岸基网页补三处：多信标列表、落水就报警、确认告警按钮
    这三项是“能不能真用起来”的关键，其余（态势图、数据记录）留在下一轮。
    一、信标列表（多信标）
    - track 本来就按编号分槽位（最多 4 只），但网页只显示“最近活跃”那一只，
    三只同时落水时只能看到最后发信号的那一只
    - JSON 加 bs 数组，列出每一只（编号/链路/定位/坐标/距岸基/方位/RSSI）
    - 网页 ② 页加一张表格；b* 那一组仍然描述“最近活跃的那只”，兼容旧代码
    二、横幅改成“信标在线就报警”
    - 原来判定是 bLink && bValid，信标刚落水、北斗还没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
2026-10-06 岸基：解析船端的速度/航向/卫星数，并给每处加“最近更新”
    一、船端的附加数据原来被丢掉了
    - 船端 S 帧是 9 个字段：S,<船ID>,<序号>,P,<有效>,<纬度>,<经度>,
    <对地速度节>,<航向度>,<卫星数>；信标帧只到经度为止
    - 岸基解析时只读前 3 个，速度/航向/卫星数在线上飘着却没接
    - 改成一次把六个字段都试着读出来，读够几个算几个：信标读到 3 个、
    船端读到 6 个，读到 6 个才填进 hasExtra 并带进 track
    - ③ 页加三张卡片：对地速度、航向、卫星数
    - 收到的是船端回的 A 帧（不带附加字段）时保留上一次的值，不清零
    二、每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
2026-10-06 岸基加态势图和数据记录（黑匣子）
    一、态势图（② 页底部）
    - 以岸基为中心、正北朝上的 canvas：中心蓝点=岸基，圆点=信标（按编号配色），
    蓝绿点=船端；距离圈自动套到整齐档位（50/100/200/500/1000/2000/5000 米）
    - 值班室最需要的就这一张图：谁在哪、离码头多远，一眼看清
    - JSON 补上 bs[].brg 和 vBrg（原来只有方位文字，画图需要角度）
    - 顺手修了个坑：网页里那条 canvas CSS 是 height:130px（船端遗留），会把
    方形图压扁，给 #smap 单独加了一条 aspect-ratio:1/1
    二、数据记录（新增 logbook 模块 + ⑤ 页）
    - 每秒把一帧系统状态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
2026-10-06 三端共存：去掉 ACK 撞车，把信道占用从 97% 降到 25%
    三端单独测都正常，但一起跑会互相打架。这次解决三个资源竞争问题：
    一、两个 ACK 撞车（最严重）
    - 信标发一帧会被船端和岸基【同时收到】，两边都回 ACK，两个 ACK 几乎
    同时发出、完全重叠，LoRa 一般两个都解不出来 —— 信标永远收不到应答，
    一直重发
    - 改成**只有船端回 ACK，岸基只听**。岸基的角色是“参考站 + 接收告警”，
    回不回 ACK 不影响它的功能
    - 代价：船端不在场时信标每轮重发 3 次（浪费一点信道，功能不受影响）
    二、信道占用接近 100%（ALOHA 理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
    [C3_Coord_Sender.ino, beacon.cpp, config.h, lora_link.cpp, lora_link.h, shore_base_node.ino, track.cpp, track.h]
2026-10-06 修两个会拖慢/停不下告警的 bug
    一、信标：碰住电极后最长要等 10 秒才报警
    - 上一轮把心跳放到 8 秒（为了降信道占用），但 loop 尾部是死等：
    delay(8000);
    这 8 秒里 waterUpdate() 根本没被调用 —— 连水感采样都停了。
    用户碰住电极，最长要等 8 秒才被发现，再加 2 秒确认，
    文档要求的“20 次入水试验激活时间不超过 3 秒”直接达不到
    - 改成“可打断的等待”：等待期间照常采样，水感状态一变就立刻返回、
    马上发下一帧。总延迟从最长 10 秒降到约 2.6 秒
    二、船端：人工确认告警之后，语音还会每 20 秒重播一次
    - ma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
    [C3_Coord_Sender.ino, beacon.cpp]
2026-10-06 信标加深度休眠与水感唤醒（power 模块），并修掉“报警依赖坐标”的问题
    一、新增 power.h / power.cpp：深度休眠 + 水感唤醒
    - 文档指标：休眠电流 ≤200µA、待机 ≥3 个月、激活后连续工作 ≥12 小时
    - 机制：平时芯片深睡（30mA → 5µA 级），水感电极挂着“低电平唤醒”；
    入水把电极拉低 → 芯片被叫醒 → 跑正常的水感确认 → 确认入水才进上报模式
    - ESP32-C3 没有 RTC IO，不能用 ext0/ext1，它用
    esp_deep_sleep_enable_gpio_wakeup()，只有 GPIO0~5 能唤醒 ——
    水感电极正好在 GPIO3/4
    - 睡着时：B 脚钉在低电平（gpio_hold_en 保持住），A 脚配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
    [C3_Coord_Sender.ino, beacon.cpp, config.h, coord.cpp, coord.h, power.cpp, power.h, radio.cpp]
2026-10-07 船端激光：修掉“船头那只初始化失败”的真凶——地址残留
    现象：串口打印“激光测距 VL53L1X（船头）初始化失败”，右舷那只正常。
    原因：VL53L1X 的 I2C 地址写在芯片里，不随 ESP32 复位恢复。船头那只被改成
    0x2A 之后，只要模块没断电，ESP32 每次重启（烧录、按 EN、看门狗）后代码去
    0x29 找它就必然找不到；右舷那只靠 XSHUT 每次开机都被复位，所以反而正常。
    改动（tof.cpp）：
    1. 开机先用裸 I2C 探总线：0x29 没人应答而 0x2A 有，就把它自动改回 0x29，
    不用断电也能恢复；
    2. 初始化失败时打印总线上真实存在的地址，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
2026-10-07 船端：激光自检、语音优先级、靠泊播报排队，修 “落水不播报”
    一、激光
    · 修 0 mm 假读数：非阻塞读之前先问 dataReady()，没测好就不读，
    并且 0 毫米一律判无效（VL53L1X 盲区 4 厘米，读到 0 一定是假的）。
    这个假读数会让靠泊把 0 米当成“贴着码头”，可能凭空触发“距岸过近”。
    · 新增串口命令 tof：两路各阻塞读 5 次，打印 距离/状态/回波强度/环境光，
    用来分清“没目标”和“芯片没在测距”。cmd 的 help 里也加上了。
    二、语音播报（这次的三个问题一起解决）
    · 报出来的是哪一路：靠泊播报前面加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
    [anchor.cpp, beacon.cpp, berth.cpp, cmd.cpp, config.h, gb2312_voice.h, tof.cpp, tof.h]
2026-10-07 船端：落水告警未确认期间，靠泊与锚泊的语音让位
    现象：人员落水后没按确认，船一移动，喇叭里就变成在念靠泊。
    原因：落水播报是“说一遍 + 最多每 20 秒重播一次”，中间那段空档语音
    通道是空闲的，靠泊播报自然就用上了 —— 不是告警丢了，是优先级没排到。
    · berth.cpp：落水告警未确认期间，靠泊的距离播报、告警、靠妥、进入监测
    全部不说；靠妥/进入监测这类挂着的一次性播报直接作废，免得告警结束
    之后才补一句过时的话。
    · anchor.cpp：同期间只更新走锚状态、不出声（状态、屏幕、蜂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
2026-10-07 船端：加本船手动坐标（室内演示）与网页语音信息栏
    一、本船手动坐标（新模块 ownpos.h / ownpos.cpp）
    问题：算信标方位、距离、搜索引导、态势图、岸基距离都要"本船在哪"，
    室内北斗定不上位，这一整片功能全都出不来。
    做法：新增"本船位置来源"统一出口，默认北斗，可切手动坐标：
    · 网页 ① 定位页签：填纬度/经度 → “设为手动坐标” / “切回北斗”
    · 串口：pos 26.212676,111.599388 设定；pos auto 切回；pos 查看
    · 设定值存在 flash（Preferences），重启不丢
    接了 6 处：beacon（信标方位距离）、shore（岸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
    [anchor.cpp, beacon.cpp, beidou_gps_test.ino, berth.cpp, cmd.cpp, config.h, logbook.cpp, net.cpp]
2026-10-07 岸基：补上数据回放与多目标救援优先级排序
    一、数据回放（⑤ 数据记录页签）
    船端一直有“加载回放 + 播放”，岸基只有暂停/清空，现在补齐：
    · 加载回放数据 / 播放暂停 两个按钮 + 拖动滑块
    · 逐条显示：时间、岸基定位与卫星、岸基坐标、信标（编号/链路/坐标/距岸基/方位）、
    船端（链路/坐标/距岸基/方位/速度）、岸侧测距
    · 自动播放每 0.3 秒一条；点“清空”同时清掉回放数据
    二、多目标救援优先级（② 落水信标页签，文档 8.4）
    · 新增“救援优先级”表：按评分从高到低排序，第一行标绿 =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
2026-10-07 船端：补上靠泊距离曲线（文档表20 态势视图三项齐了）
    文档表20 要求态势视图显示“落水点、靠泊距离曲线、停泊位移趋势”。
    落水点（⑥ 信标态势图）和停泊位移趋势（⑤ 锚泊曲线）早就有，
    这次把靠泊距离曲线补上。
    · config.h：BERTH_HIST_N=90 点 × 1 秒 = 最近 1.5 分钟，只用 360 字节内存
    · berth.cpp：每秒把滤波后的距离记进环形缓冲；不管在不在监测都记，
    所以能看到“还没进 3.5 米”之前的接近过程；无效读数记 -1
    · berth.cpp：新增 berthDistanceHistory()，按从旧到新拼成逗号分隔字符串
    · net.cpp：④ 靠泊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
2026-10-07 修“落水告警整场只响一次”的 bug；岸基补语音信息栏与音量控制
    一、落水告警只响一次的 bug（船端 beacon.cpp + 岸基 track.cpp）
    现象：确认过一次落水告警之后，同一个信标再落水就不响了，必须重启板子。
    原因：“已确认”标志只在“链路失联”时复位，而信标平时一直发心跳（8 秒一帧），
    链路根本不断 —— 于是标志永远是 true，整场只报警一次。
    改法：把“事件结束”的判据补全，两处都清状态：
    · 信标这一帧报“没水”（人已离开水面）→ 清“已确认”和“已播报过”，
    下次落水按新事件立刻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
    [beacon.cpp, net.cpp, track.cpp, voice.cpp, voice.h]
2026-10-07 船端：加 TB6612 电机驱动（单路，STBY 常开）
    新增 motor.h / motor.cpp，只占 3 个引脚（STBY 直接接 3.3V 常开）：
    AIN1 -> GPIO2 AIN2 -> GPIO15 PWMA -> GPIO12（LEDC 5kHz）
    选这三个脚的原因：船端其余引脚已被北斗/激光/OLED/MPU/磁力计/LoRa/语音/蜂鸣器占满，
    2/12/15 是仅剩的三个可作输出的空闲脚（34~39 只能输入，1/3 是 USB 串口，
    6~11 是内部 flash）。已在 config.h 注释里写明“这两根不要外接上拉”。
    模块内置三条保护，都按船模的实际需要来的：
    · 软启动/软停：油门每秒最多变 80%（约 1.3 秒到全速），避免突然全速打滑甚至翻船
    ·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
2026-10-08 船端：加靠泊联锁——靠泊告警时自动收油门
    问题：靠泊告警只响蜂鸣器和语音，电机照样在转，等于“一边报警一边加速”。
    做法：给电机加两级靠泊联锁，在 motorUpdate() 里读靠泊告警码：
    · 0x01 接近速度偏大（提醒级）→ 油门上限压到 MOTOR_BERTH_WARN_CAP（默认 30%），
    告警解除后自动恢复上限
    · 0x02 速度过大 / 0x03 距岸过近（严重级）→ 立即 motorBrake() 刹车并置联锁，
    联锁期间 motorSetThrottle() 直接拒绝新油门，告警解除后也要重新给油门才动
    为什么严重级要“联锁”而不是“自动恢复”：告警解除时若自动把油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
    [config.h, motor.cpp, motor.h, net.cpp]
2026-10-08 船端：电机加正常限速，靠泊提醒级进一步降到 10%
    原来只有“靠泊联锁”在管油门，正常情况仍可给到 100%，船模容易一窜出去。
    现在改成三级油门上限：
    正常情况 → MOTOR_CAP_NORMAL（默认 30%）
    0x01 提醒级（速度偏大） → MOTOR_BERTH_WARN_CAP（默认 10%）
    0x02/0x03 严重级 → 立即刹车并锁定（重新给油门才恢复）
    · config.h 新增 MOTOR_CAP_NORMAL；把 MOTOR_BERTH_WARN_CAP 从 0.30 改成 0.10，
    并把两个上限的作用与“设 0 只关告警联锁、正常上限仍生效”写进注释
    · motor.cpp 上限改为“正常上限 / 提醒级上限”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
2026-10-09 船端/岸基：加“演示模式”开机直开热点；修激光读数闪“无效”
    现场演示不再依赖路由器：新增 FORCE_AP 开关，打开后开机跳过扫描与连接，
    直接开自己的热点（船端 Beidou-GPS、岸基 Shore-Base，密码都是 12345678），
    地址固定 192.168.4.1。这样做绕开了路由器无线隔离、2.4G/5G 混用、
    固定 IP 被占用这一整类问题——之前板子在跑、日志正常，但电脑既 ping 不到、
    也没看到它开热点，就是这个原因。想改回连路由器把开关改成 0 重新烧录即可。
    船端：
    1) 右侧激光暂时停用（TOF_SIDE_ENABLE = 0），先单路跑测试；同时把 XSHUT
    无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
    [berth.cpp, config.h, net.cpp, tof.cpp]
2026-10-09 船端/信标：OLED 超量程留白、按距岸分档收油；信标打开姿态判据
    船端 —— OLED 不再显示"激光无效"：
    · tof.h/tof.cpp 新增 tofFailCode() 与 tofOutOfRange()，把已经存下来的
    失败状态码暴露出去，OLED 才能分清"看不到东西"和"设备/线有问题"。
    · tofOutOfRange() 把 SigmaFail / SignalFail / OutOfBoundsFail /
    WrapTargetFail 都算作"看不到东西"（对着远处空处最常见的四种返回），
    前提是传感器仍在正常出结果——连结果都没有说明是掉线，那种要显示。
    · oled.cpp 本船状态第 4 行改成四种情况：模块没起来显示"未连接"、
    有读数显示数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
    [config.h, motor.cpp, oled.cpp, tof.cpp, tof.h]
